newdexterity/Robotic-Speedboats/Trimaran/Version 2/Version 2 Stationary.jpg

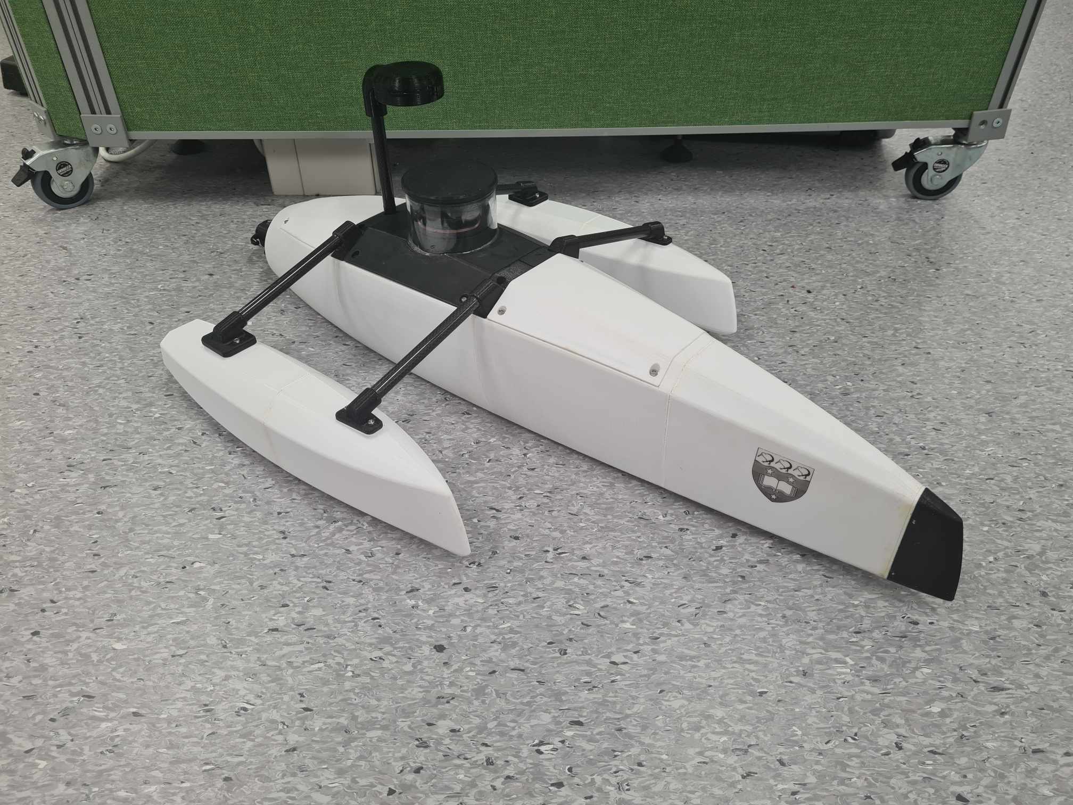
Trimaran/Version 2/Version 2 Stationary.jpg
