newdexterity/Robotic-Speedboats/Trimaran/Version 1 + 2.jpg

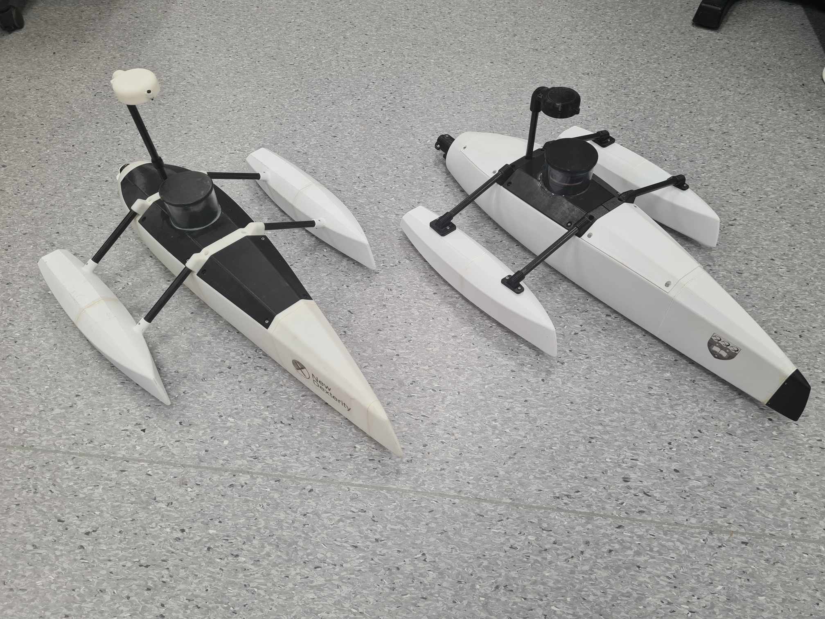
Trimaran/Version 1 + 2.jpg
