newdexterity/Robotic-Speedboats/Trimaran/Software/Software_Ardupilot_Trimaran.pdf

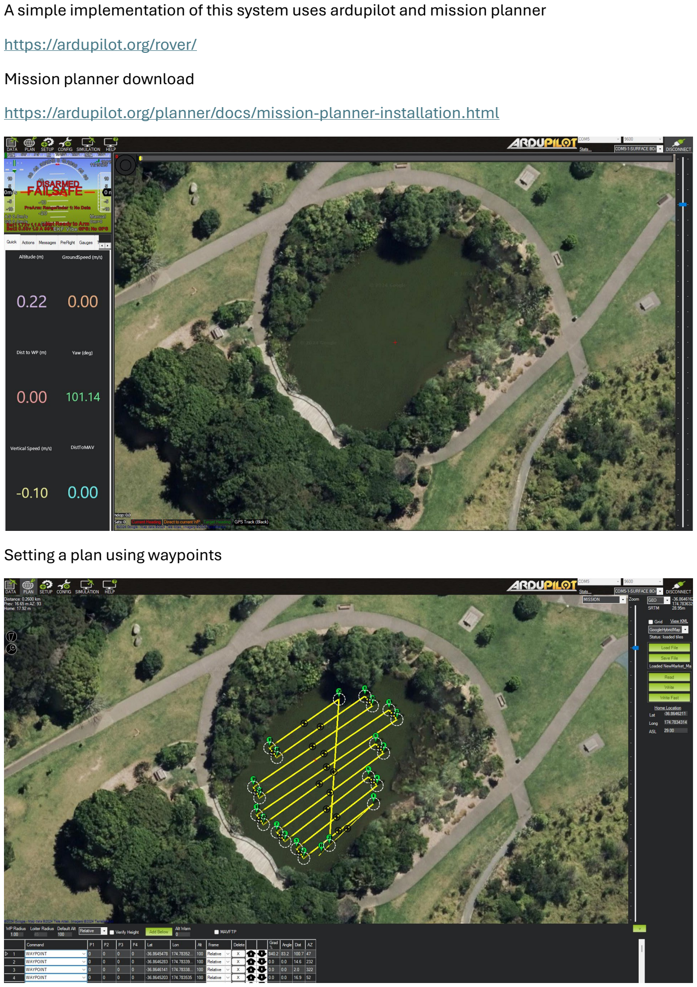
[picture p3: page 1]

A simple implementation of this system uses ardupilot and mission planner https://ardupilot.org/rover/
Mission planner download
https://ardupilot.org/planner/docs/mission-planner-installation.html

Setting a plan using waypoints

Tuning inputs

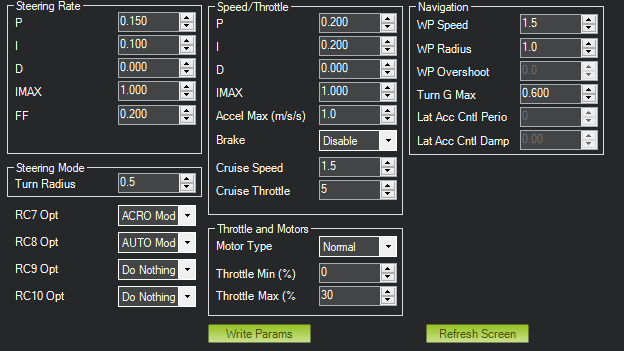
[picture p4: figure]

Parameters file can be used for the rest of the requirements
Overview of main parameters:
FRAME_CLASS = 2 (Boat)
Sonar (https://ardupilot.org/copter/docs/common-bluerobotics-ping.html)
- SERIAL2_PROTOCOL (https://ardupilot.org/copter/docs/parameters.html#serial2-protocol) = 9 (Lidar)
- SERIAL2_BAUD (https://ardupilot.org/copter/docs/parameters.html#serial2-baud) = 115 (115200 baud)
- RNGFND1_TYPE (https://ardupilot.org/copter/docs/parameters.html#rngfnd1-type) = 23 (BlueRoboticsPing)
- RNGFND1_MIN_CM (https://ardupilot.org/copter/docs/parameters.html#rngfnd1-min-cm) = 30
- RNGFND1_MAX_CM (https://ardupilot.org/copter/docs/parameters.html#rngfnd1-max-cm) = 2600. This is the distance in centimeters that the rangefinder can reliably read.
- RNGFND1_ORIENT (https://ardupilot.org/copter/docs/parameters.html#rngfnd1-orient) = 25 (down) if mounted on a boat

Lidar (https://ardupilot.org/copter/docs/common-rplidar-a2.html)
- SERIAL1_PROTOCOL (https://ardupilot.org/copter/docs/parameters.html#serial1-protocol) = “11” (“Lidar360”) if using Serial1
- SERIAL1_BAUD (https://ardupilot.org/copter/docs/parameters.html#serial1-baud) = “115” for C1/A2, “256” for S1,A2M12 if using Serial1
- PRX1_TYPE (https://ardupilot.org/copter/docs/parameters.html#prx1-type) = “5”
- PRX1_ORIENT (https://ardupilot.org/copter/docs/parameters.html#prx1-orient) = “0” if mounted on the top of the vehicle, “1” if mounted upside-down on the bottom of the vehicle.

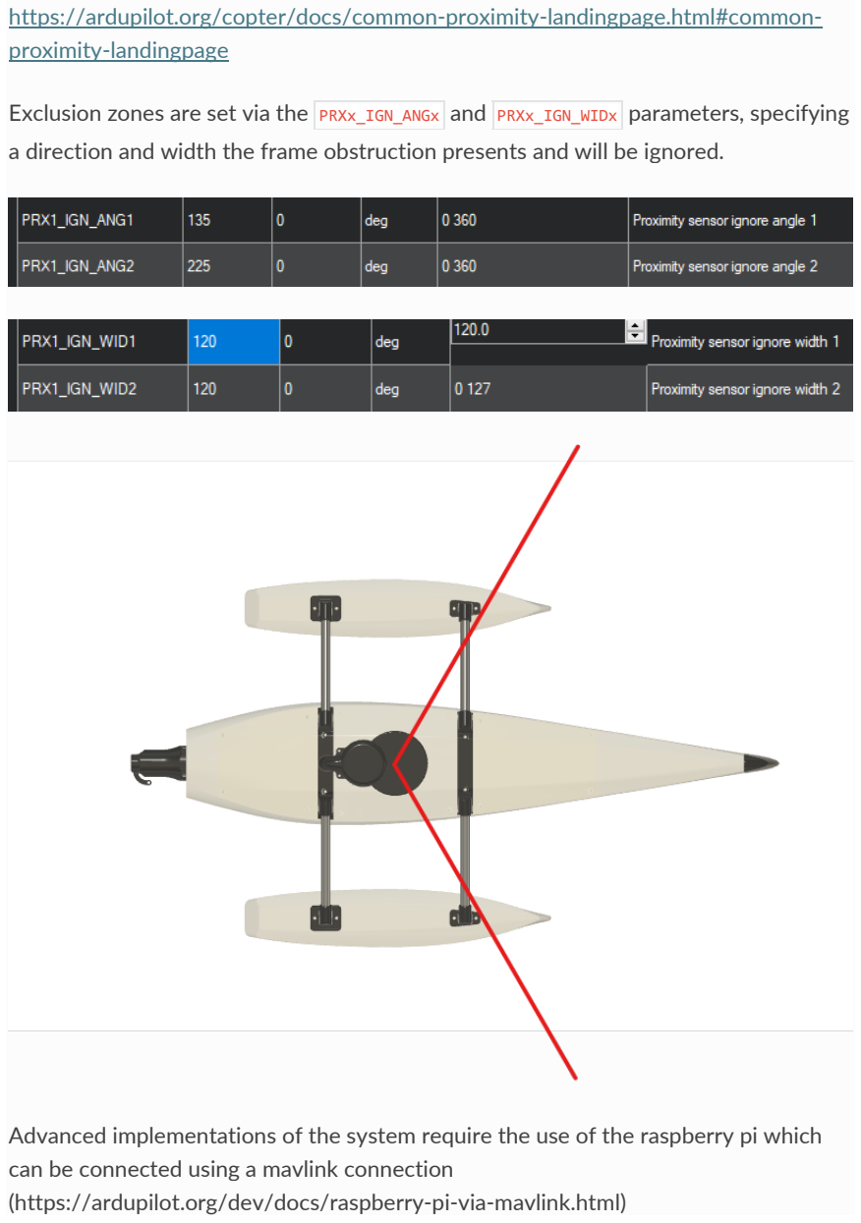
[picture p5: page 3]

https://ardupilot.org/copter/docs/common-proximity-landingpage.html#commonproximity-landingpage (https://ardupilot.org/copter/docs/common-proximity-landingpage.html#common-proximity-landingpage)

Exclusion zones are set via the | and | parameters, specifying
PRXx_IGN_ANGx | PRXx_IGN_WIDx
a direction and width the frame obstruction presents and will be ignored.

Advanced implementations of the system require the use of the raspberry pi which can be connected using a mavlink connection (https://ardupilot.org/dev/docs/raspberry-pi-via-mavlink.html)
