newdexterity/Robotic-Speedboats/Catamaran/Hull_Cover/Cover Rear.3mf

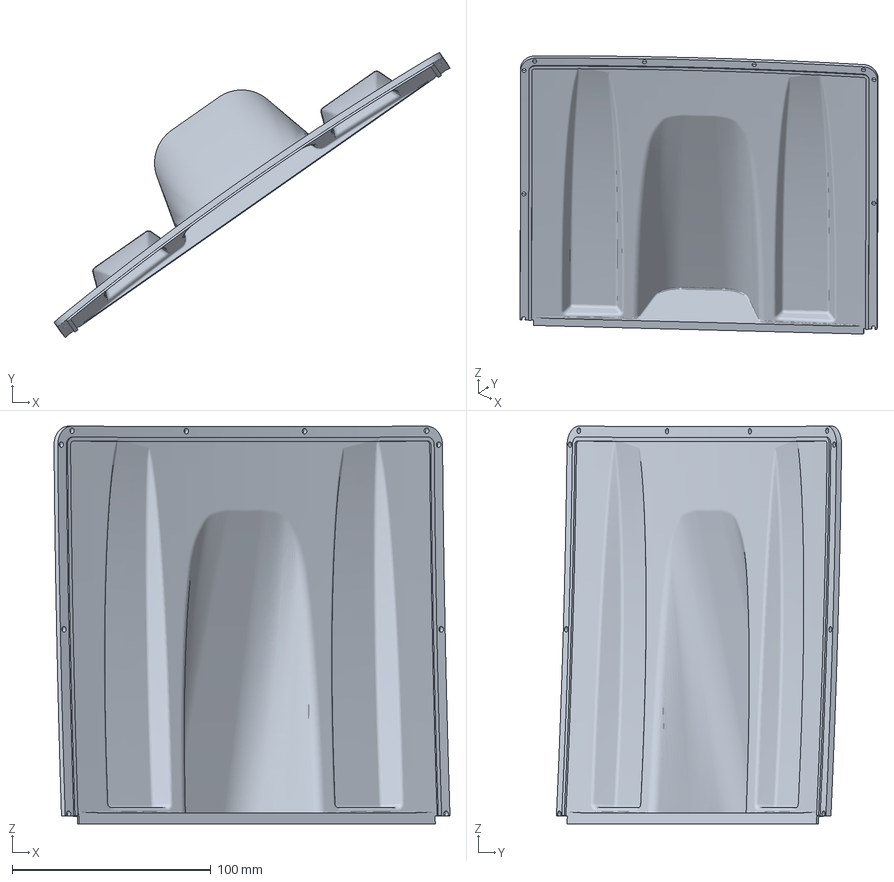
[picture p6: CAD file, 2021-09-22]
Catamaran/Hull_Cover/Cover Rear.3mf
199.0 x 143.3 x 199.9 mm
