newdexterity/Robotic-Speedboats/Catamaran/Hull_Cover/STEP/Hull_Cover.stp

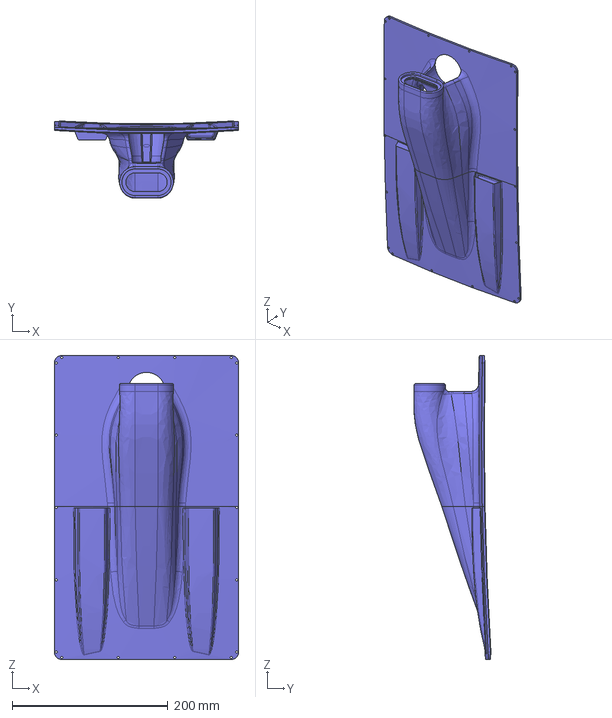
[picture p7: CAD file, 2024-03-28]
Catamaran/Hull_Cover/STEP/Hull_Cover.stp
236.5 x 98.8 x 390.0 mm
