newdexterity/Robotic-Speedboats/Catamaran/Jet/Impeller/Impeller_4-40-12.stp

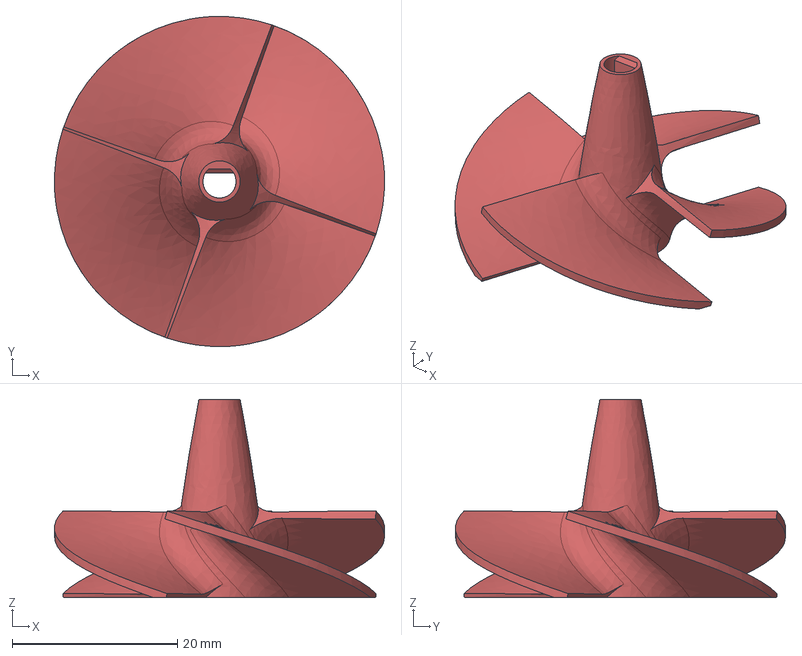
[picture p8: CAD file, 2024-03-28]
Catamaran/Jet/Impeller/Impeller_4-40-12.stp
40.0 x 40.0 x 24.0 mm
