newdexterity/Robotic-Speedboats/Catamaran/Jet/Thrust_vector.stp

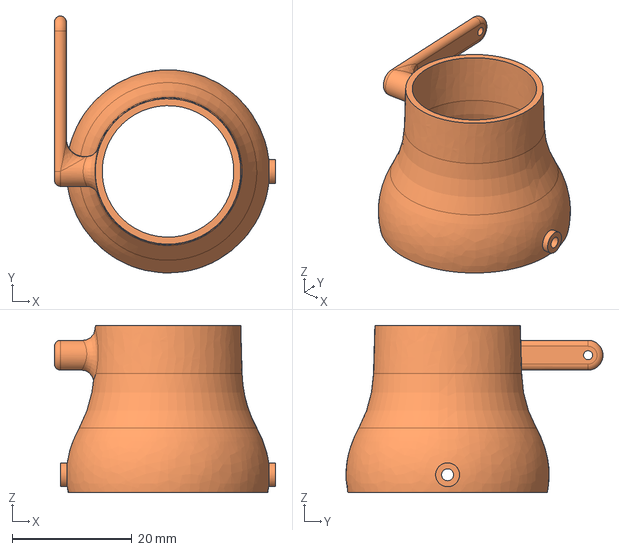
[picture p10: CAD file, 2024-03-28]
Catamaran/Jet/Thrust_vector.stp
37.0 x 43.0 x 28.0 mm
