newdexterity/Robotic-Speedboats/Catamaran/Mounts/Sensors_SubFrame.stp

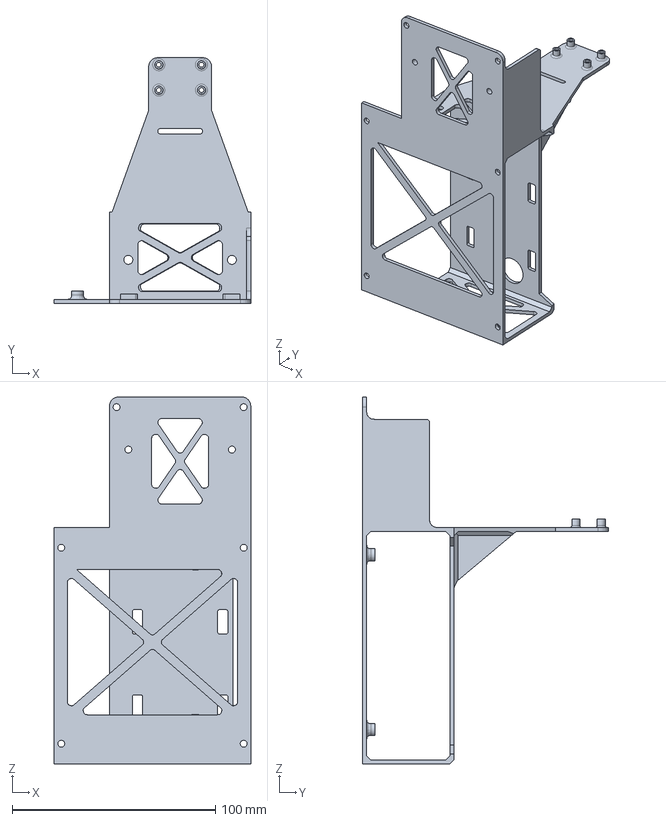
[picture p11: CAD file, 2024-03-28]
Catamaran/Mounts/Sensors_SubFrame.stp
96.8 x 121.0 x 180.7 mm
