newdexterity/Robotic-Speedboats/Trimaran/Version 2/Cover/Lid_Middle.3mf

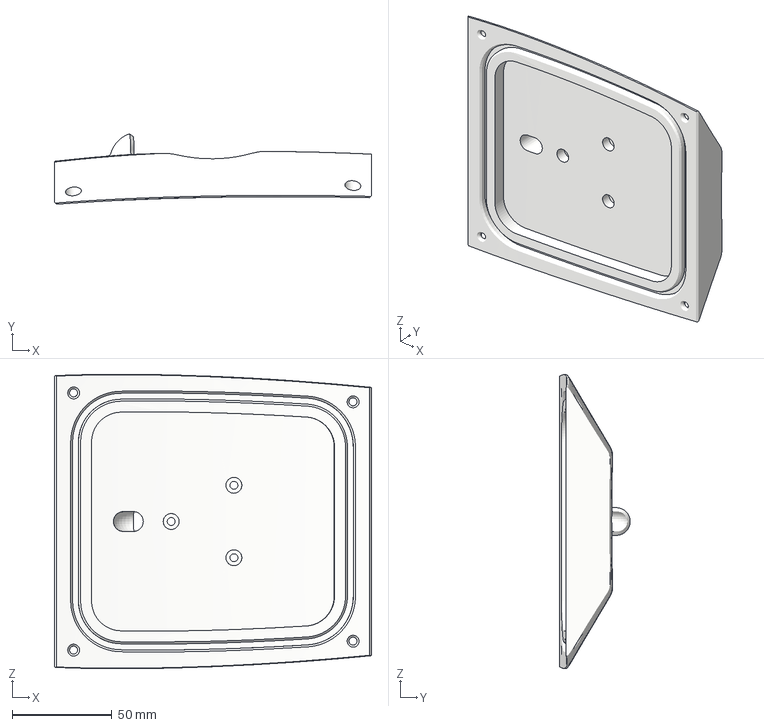
[picture p12: CAD file, 2024-07-31]
Trimaran/Version 2/Cover/Lid_Middle.3mf
159.2 x 35.4 x 147.9 mm
