newdexterity/Robotic-Speedboats/Trimaran/Version 2/Hull/Hull_tube_mount_right_rear.3mf

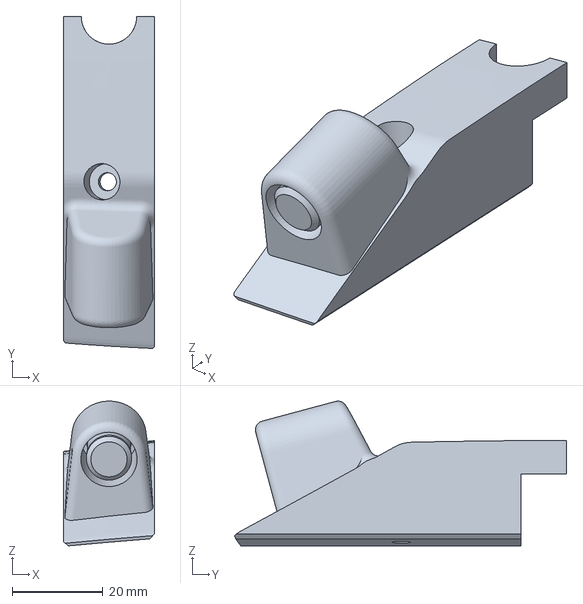
[picture p13: CAD file, 2024-07-31]
Trimaran/Version 2/Hull/Hull_tube_mount_right_rear.3mf
20.0 x 73.2 x 31.9 mm
