newdexterity/Robotic-Speedboats/Trimaran/Version 2/Jet/Stator.3mf

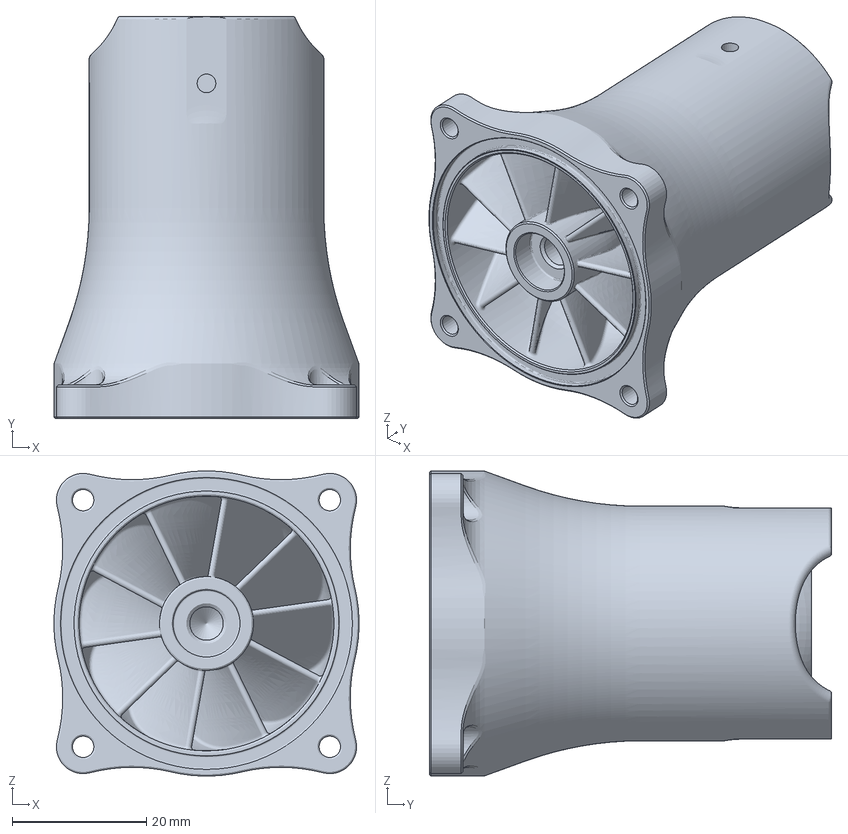
[picture p14: CAD file, 2024-03-28]
Trimaran/Version 2/Jet/Stator.3mf
45.5 x 60.0 x 45.5 mm
