newdexterity/Robotic-Speedboats/Trimaran/Version 2/Mount/RasberryPi_Box_Mount.3mf

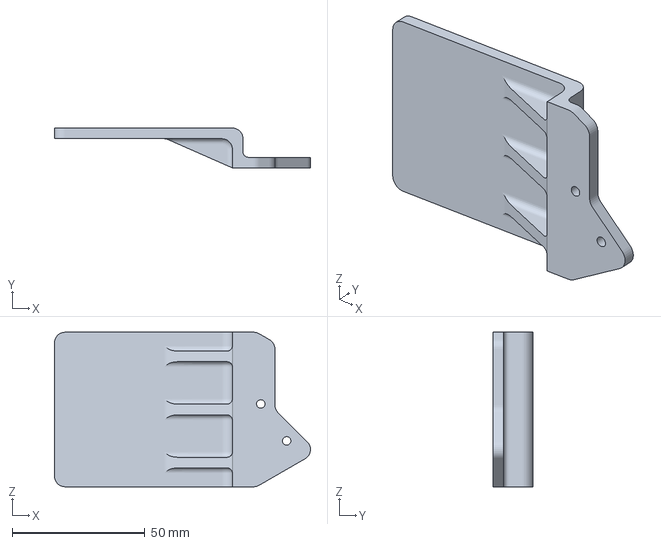
[picture p15: CAD file, 2024-03-28]
Trimaran/Version 2/Mount/RasberryPi_Box_Mount.3mf
96.4 x 15.0 x 58.2 mm
