newdexterity/Robotic-Speedboats/Catamaran/Hull_Cover/Hull Cutout Front.3mf

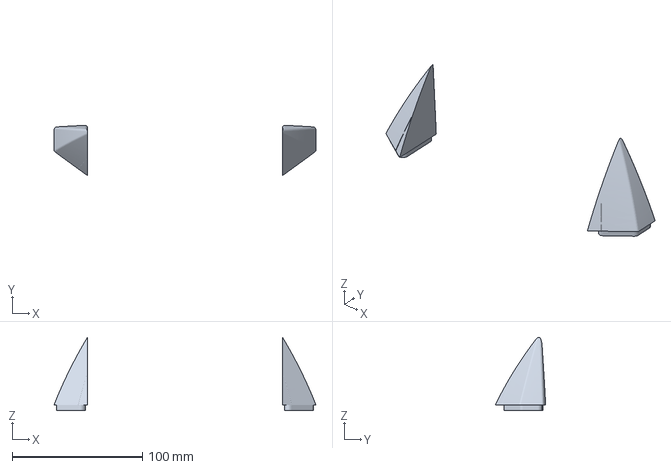
[picture p16: CAD file, 2021-09-22]
Catamaran/Hull_Cover/Hull Cutout Front.3mf
201.5 x 38.8 x 56.5 mm
