newdexterity/Robotic-Speedboats/Catamaran/Jet/Nozzle/Nozzle_25_12.stp

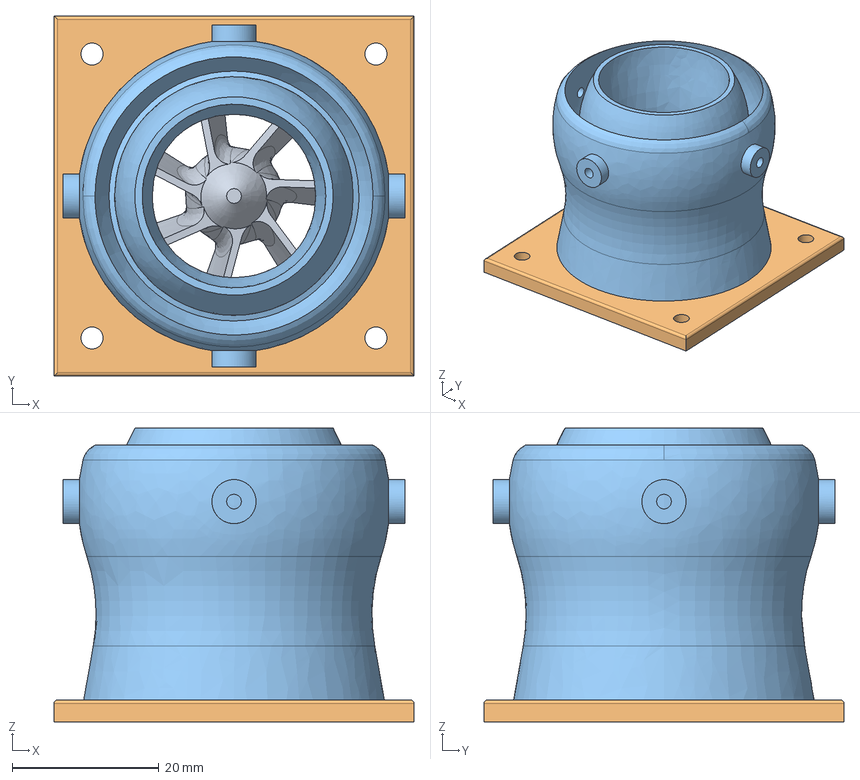
[picture p17: CAD file, 2024-03-28]
Catamaran/Jet/Nozzle/Nozzle_25_12.stp
49.0 x 49.0 x 40.0 mm
