newdexterity/Robotic-Speedboats/Catamaran/Jet/Reverse_Bucket.stp

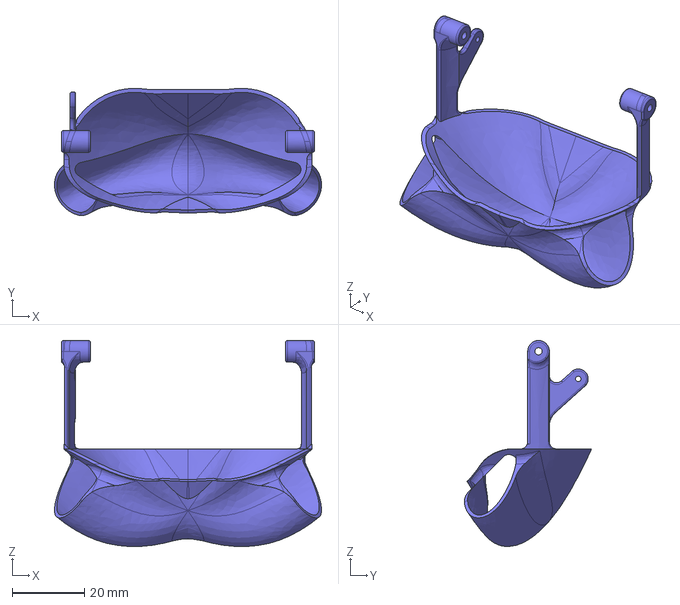
[picture p18: CAD file, 2024-03-28]
Catamaran/Jet/Reverse_Bucket.stp
73.9 x 35.2 x 57.0 mm
