newdexterity/Robotic-Speedboats/Catamaran/Mounts/Motor Mount.stp

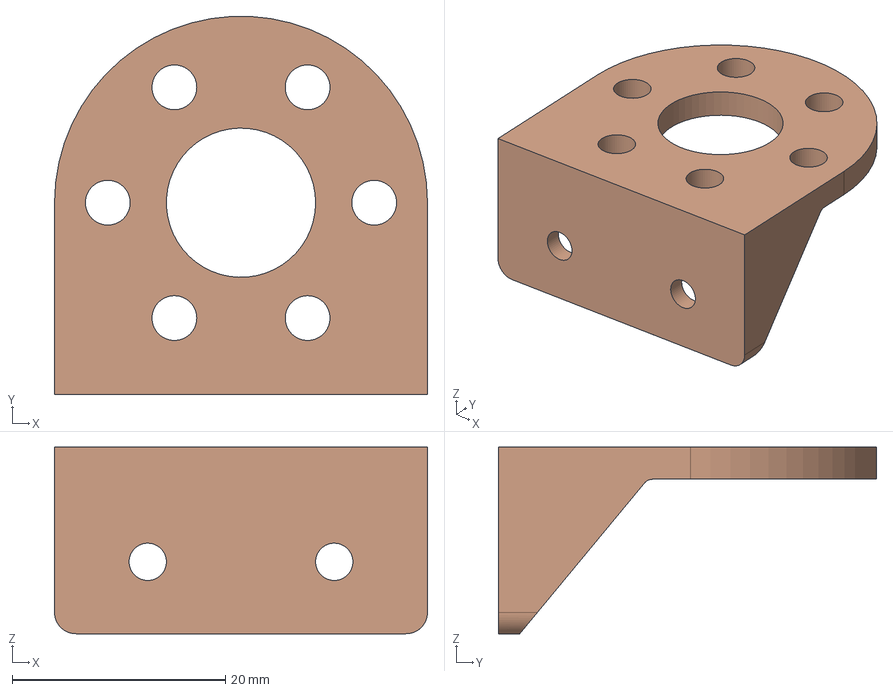
[picture p19: CAD file, 2024-03-28]
Catamaran/Mounts/Motor Mount.stp
35.0 x 35.5 x 17.5 mm
