newdexterity/Robotic-Speedboats/Trimaran/Version 2/Cover/Lid_Rear.3mf

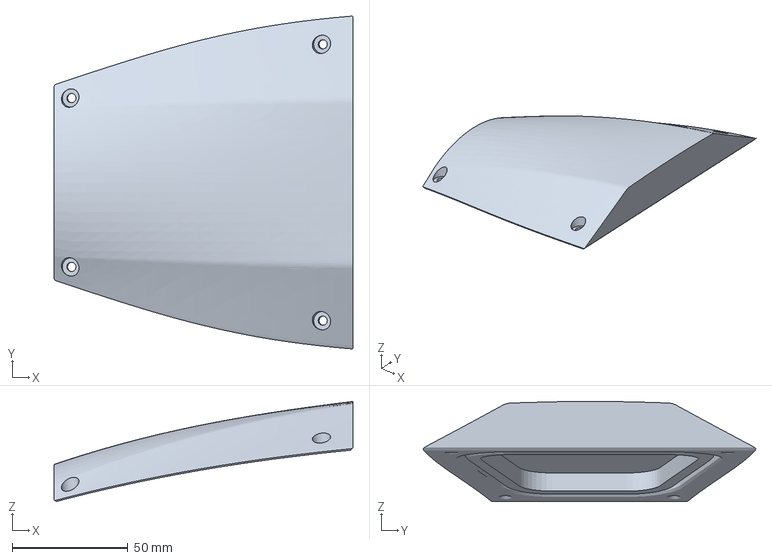
[picture p20: CAD file, 2024-03-28]
Trimaran/Version 2/Cover/Lid_Rear.3mf
129.2 x 143.8 x 43.3 mm
