newdexterity/Robotic-Speedboats/Trimaran/Version 2/Hull/Left_Rear_Side_Pod.3mf

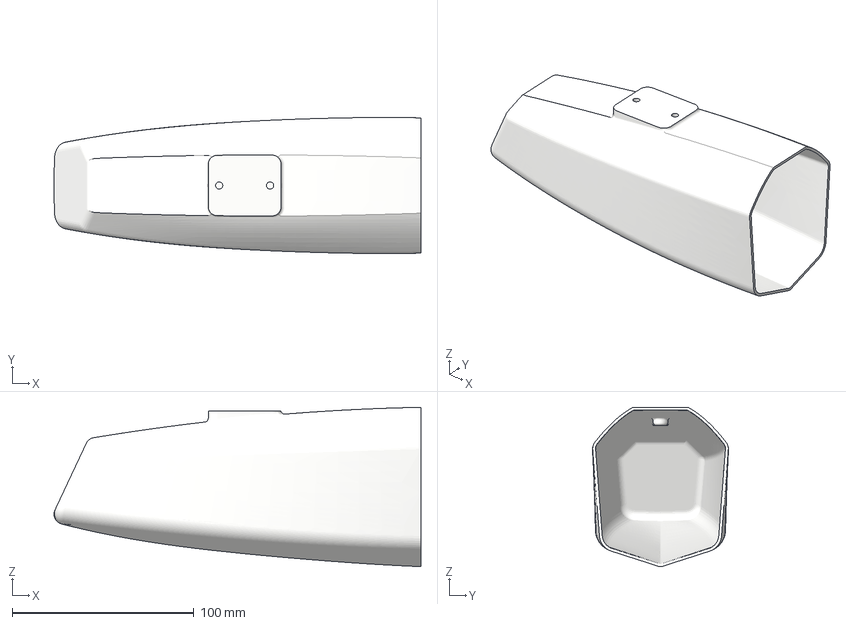
[picture p21: CAD file, 2024-07-31]
Trimaran/Version 2/Hull/Left_Rear_Side_Pod.3mf
201.8 x 74.8 x 87.6 mm
