newdexterity/Robotic-Speedboats/Trimaran/Version 2/Jet/Vector.3mf

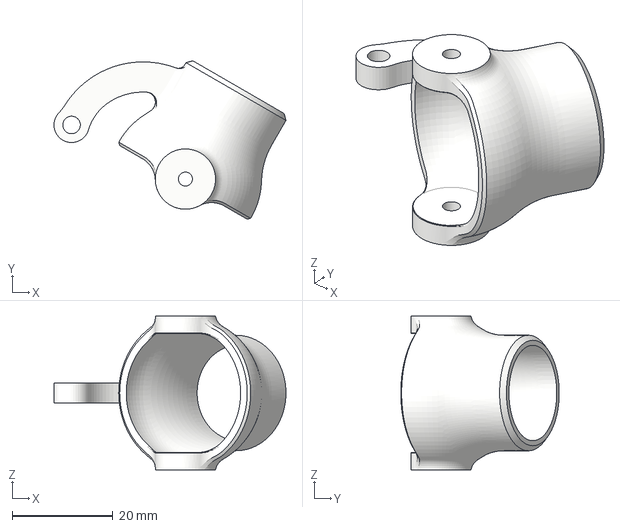
[picture p22: CAD file, 2024-03-28]
Trimaran/Version 2/Jet/Vector.3mf
46.2 x 31.5 x 30.6 mm
