newdexterity/Robotic-Speedboats/Trimaran/Version 2/Mount/Motor_Mount.3mf

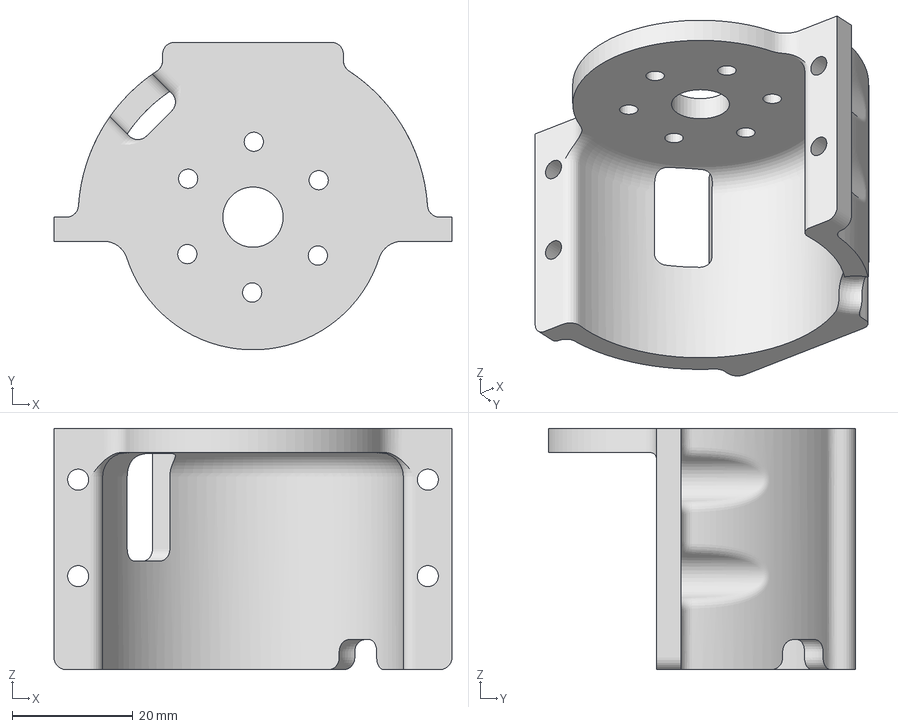
[picture p23: CAD file, 2024-03-28]
Trimaran/Version 2/Mount/Motor_Mount.3mf
66.0 x 51.0 x 40.0 mm
