newdexterity/Robotic-Speedboats/Catamaran/Hull_Cover/Hull Cutout Mid Rear.3mf

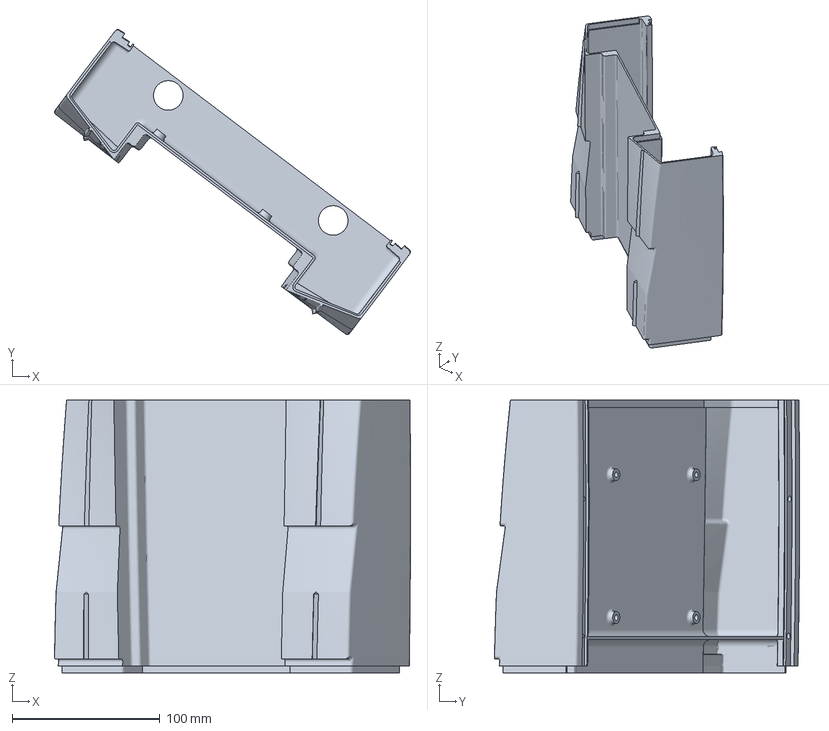
[picture p24: CAD file, 2021-09-22]
Catamaran/Hull_Cover/Hull Cutout Mid Rear.3mf
240.8 x 206.4 x 184.5 mm
