newdexterity/Robotic-Speedboats/Catamaran/Jet/Thrust_vector-Nozzle_20.stl

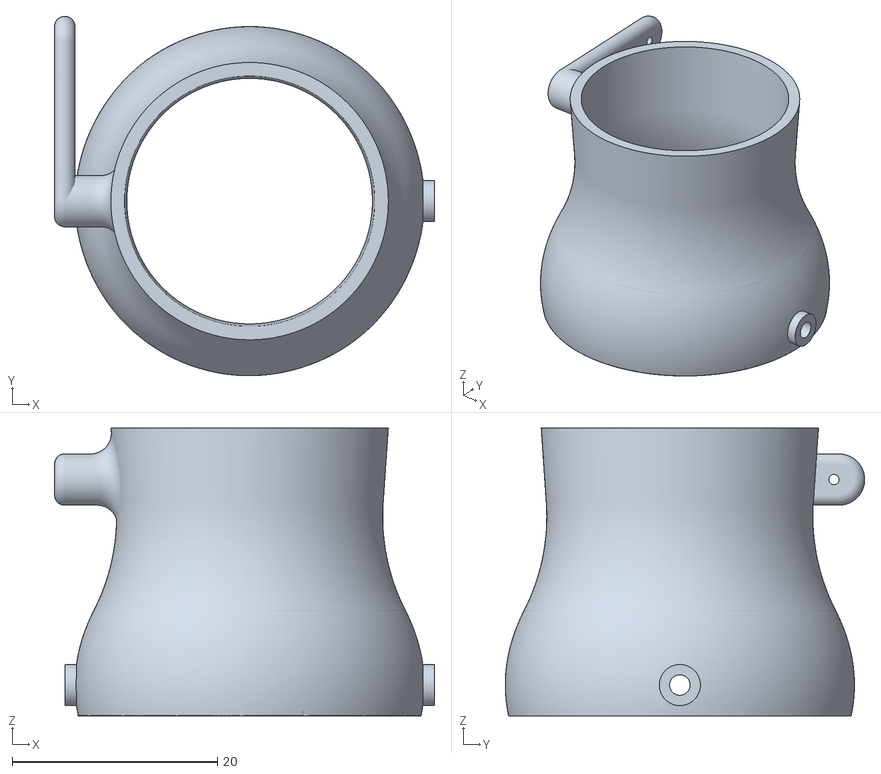
[picture p25: CAD file, 2021-09-22]
Catamaran/Jet/Thrust_vector-Nozzle_20.stl
37.0 x 35.0 x 28.0
