newdexterity/Robotic-Speedboats/Catamaran/Mounts/Powertrain_SubFrame.stp

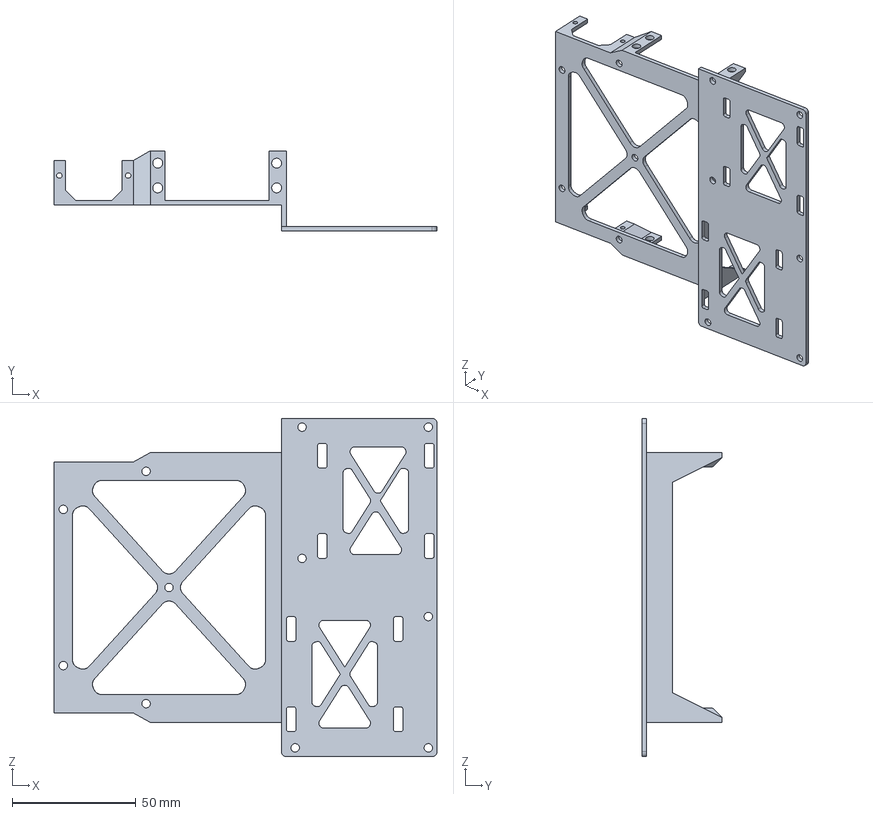
[picture p26: CAD file, 2024-03-28]
Catamaran/Mounts/Powertrain_SubFrame.stp
154.7 x 32.5 x 136.5 mm
