newdexterity/Robotic-Speedboats/Trimaran/Version 2/Cover/Lid_Front.3mf

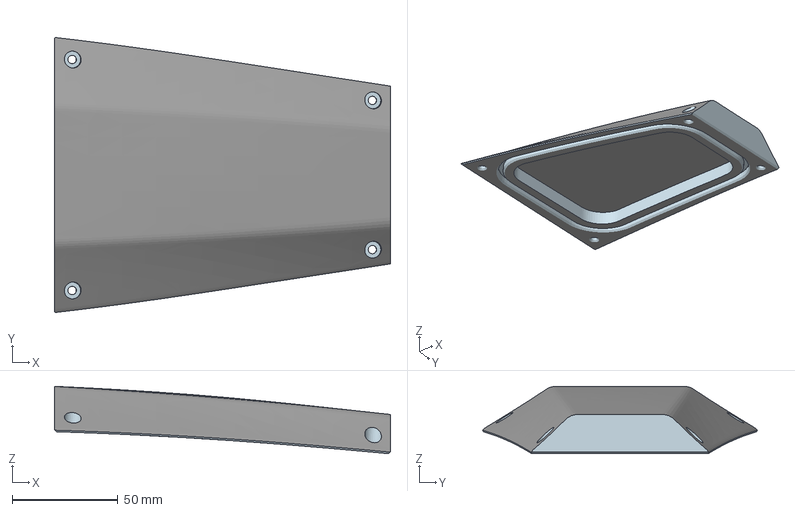
[picture p27: CAD file, 2024-03-28]
Trimaran/Version 2/Cover/Lid_Front.3mf
159.2 x 130.3 x 31.9 mm
