newdexterity/Robotic-Speedboats/Trimaran/Version 2/Hull/Side_pod_tube_mount_left_rear.3mf

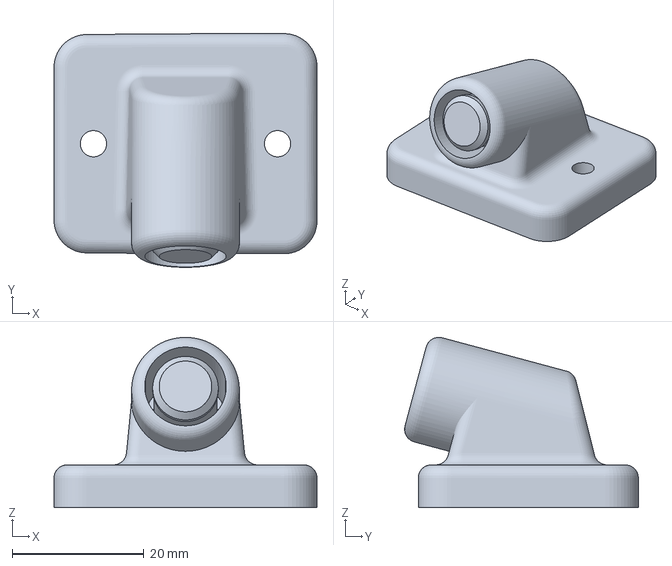
[picture p28: CAD file, 2024-07-31]
Trimaran/Version 2/Hull/Side_pod_tube_mount_left_rear.3mf
40.0 x 35.6 x 25.9 mm
