newdexterity/Robotic-Speedboats/Trimaran/Version 2/Mount/Pixhawk_Box_Holder.3mf

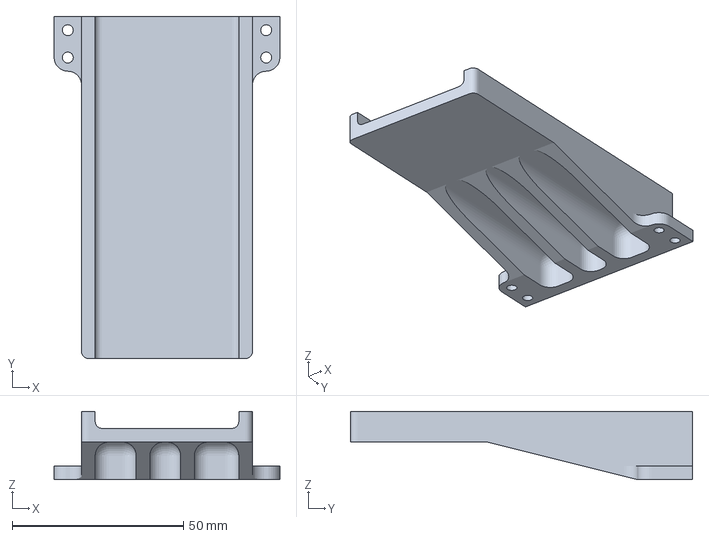
[picture p29: CAD file, 2024-03-28]
Trimaran/Version 2/Mount/Pixhawk_Box_Holder.3mf
66.0 x 100.0 x 20.0 mm
