newdexterity/Robotic-Speedboats/Catamaran/Hull_Cover/Hull Cutout Rear.3mf

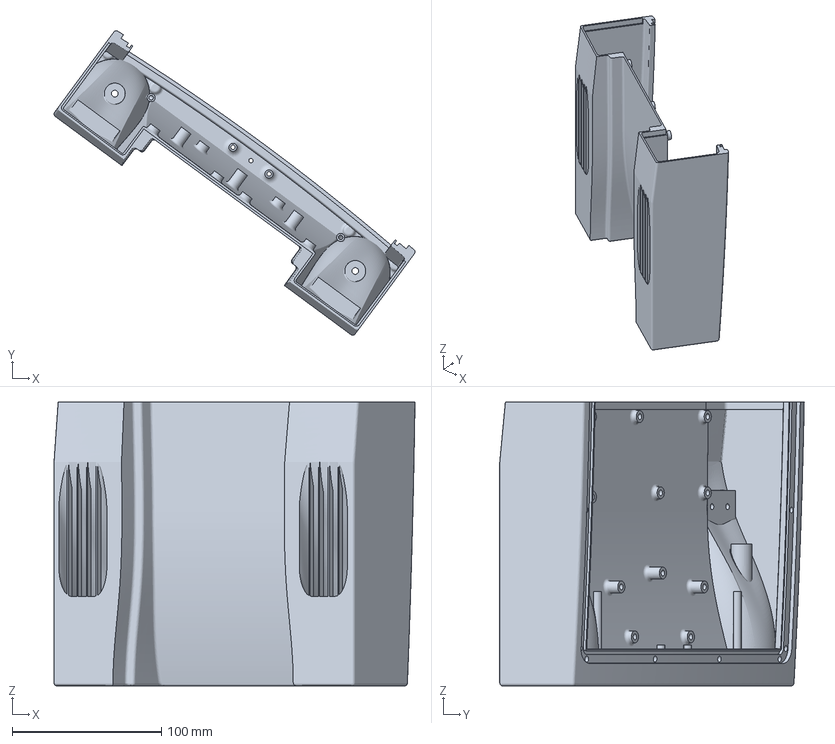
[picture p30: CAD file, 2021-09-22]
Catamaran/Hull_Cover/Hull Cutout Rear.3mf
241.6 x 203.8 x 190.0 mm
