newdexterity/Robotic-Speedboats/Catamaran/Jet/Impeller/Impeller_20_40_4.stl

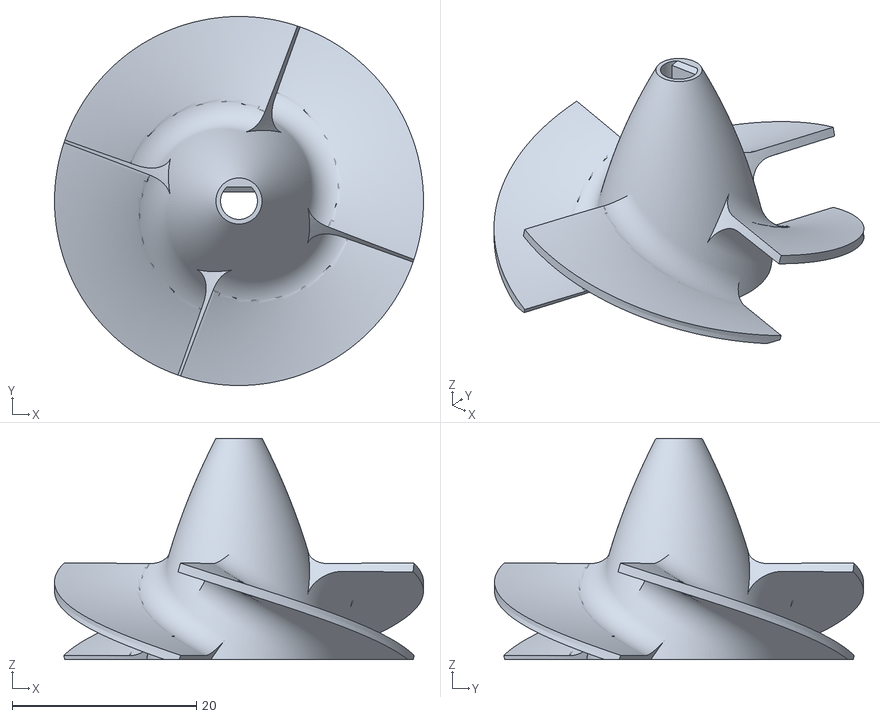
[picture p31: CAD file, 2021-09-22]
Catamaran/Jet/Impeller/Impeller_20_40_4.stl
40.0 x 40.0 x 24.0
