newdexterity/Robotic-Speedboats/Trimaran/Version 2/Hull/Hull_tube_mount_left_front.3mf

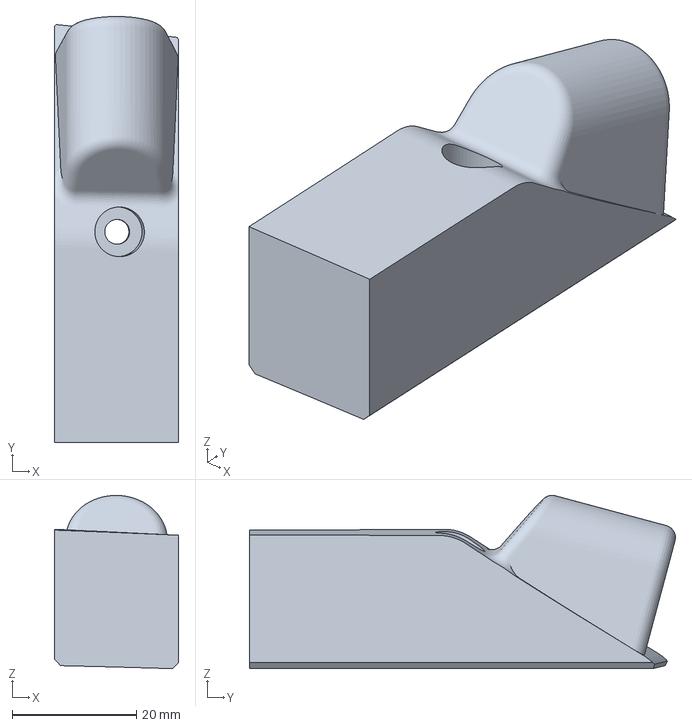
[picture p32: CAD file, 2024-07-31]
Trimaran/Version 2/Hull/Hull_tube_mount_left_front.3mf
20.0 x 68.6 x 27.9 mm
