newdexterity/Robotic-Speedboats/Trimaran/Version 2/Mount/Servo_Mount.3mf

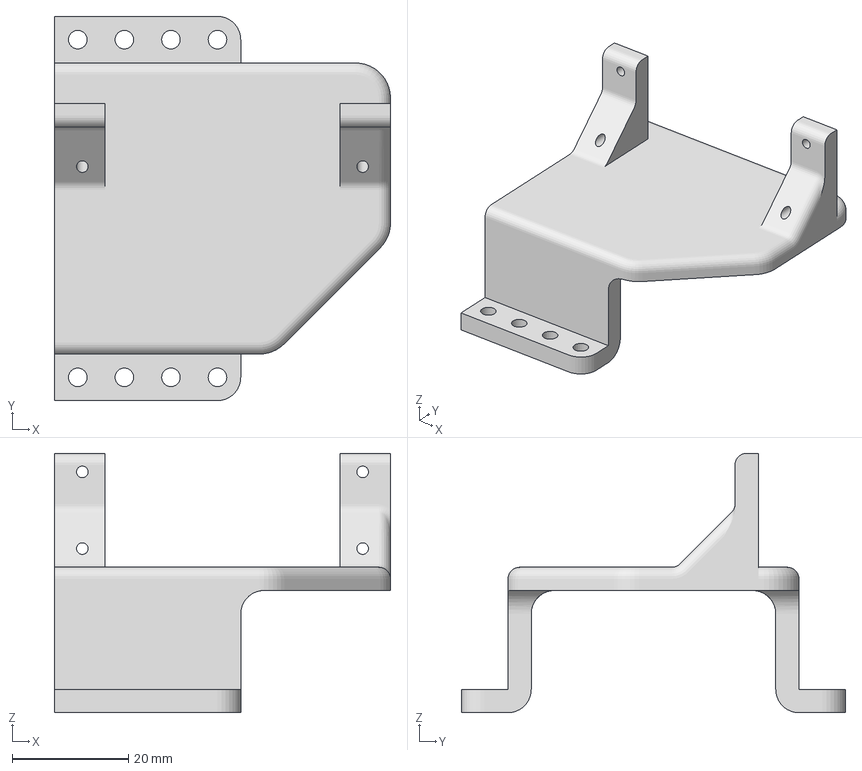
[picture p33: CAD file, 2024-03-28]
Trimaran/Version 2/Mount/Servo_Mount.3mf
57.7 x 66.0 x 44.6 mm
