newdexterity/Robotic-Speedboats/Catamaran/Hull_Cover/Cover Front.3mf

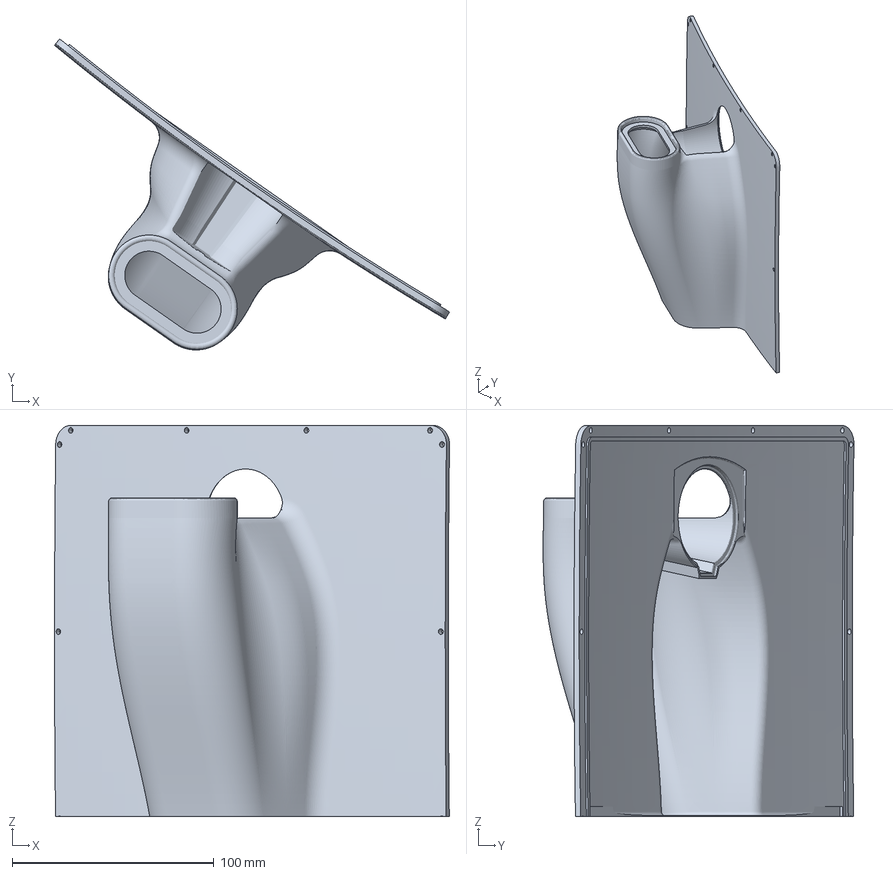
[picture p34: CAD file, 2021-09-22]
Catamaran/Hull_Cover/Cover Front.3mf
195.8 x 154.2 x 194.0 mm
