newdexterity/Robotic-Speedboats/Catamaran/Jet/Impeller/Impeller_12_50_4.stl

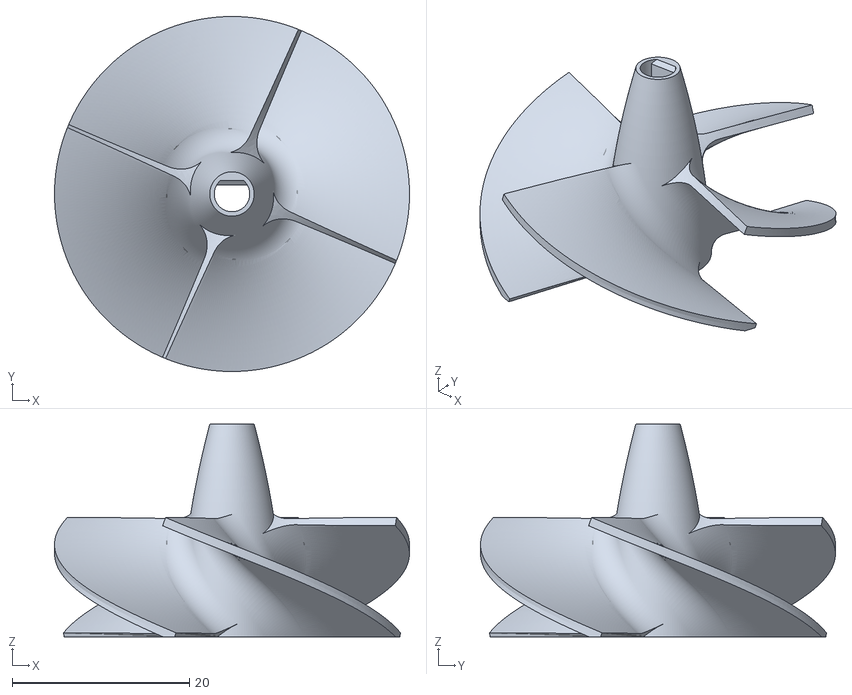
[picture p35: CAD file, 2021-09-22]
Catamaran/Jet/Impeller/Impeller_12_50_4.stl
40.0 x 40.0 x 24.0
