newdexterity/Robotic-Speedboats/Trimaran/Version 2/Hull/Left_Front_Side_Pod.3mf

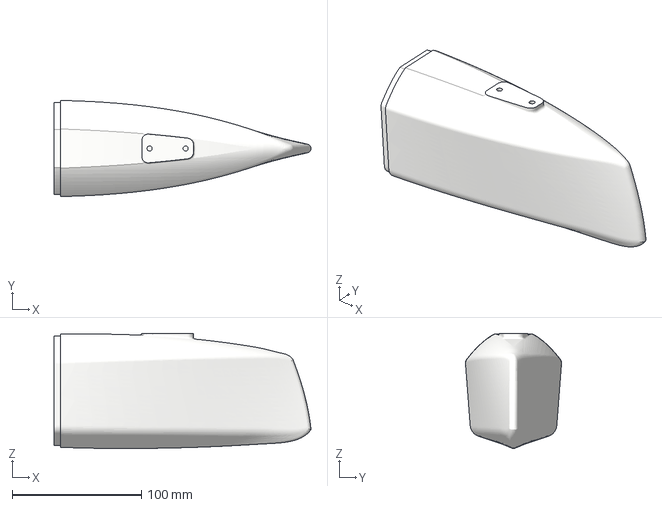
[picture p36: CAD file, 2024-07-31]
Trimaran/Version 2/Hull/Left_Front_Side_Pod.3mf
199.1 x 74.4 x 89.1 mm
