newdexterity/Robotic-Speedboats/Trimaran/Version 2/Mount/Sonar_Top.3mf

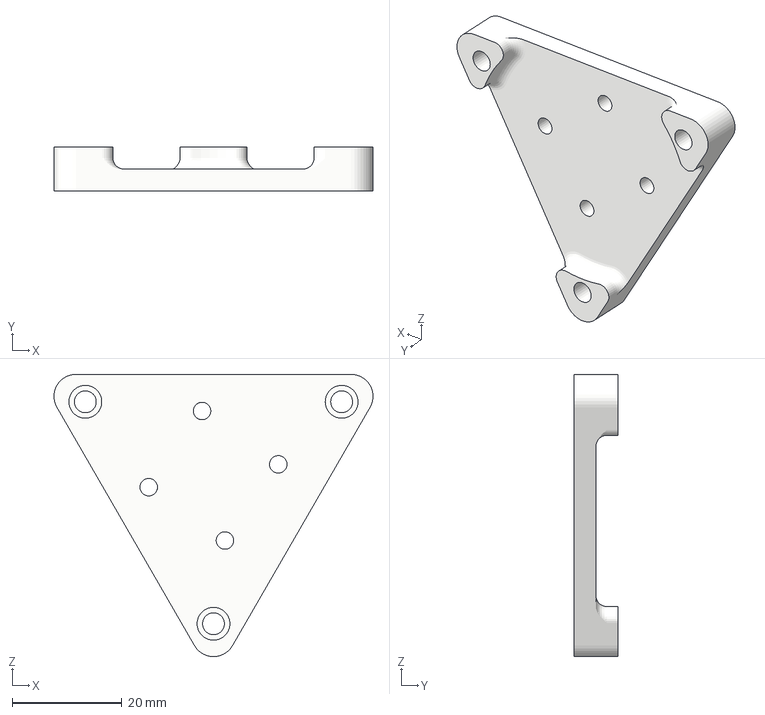
[picture p37: CAD file, 2024-03-28]
Trimaran/Version 2/Mount/Sonar_Top.3mf
58.2 x 8.00 x 51.5 mm
