newdexterity/Robotic-Speedboats/Catamaran/Hull_Cover/Hull Cutout Front Mid.3mf

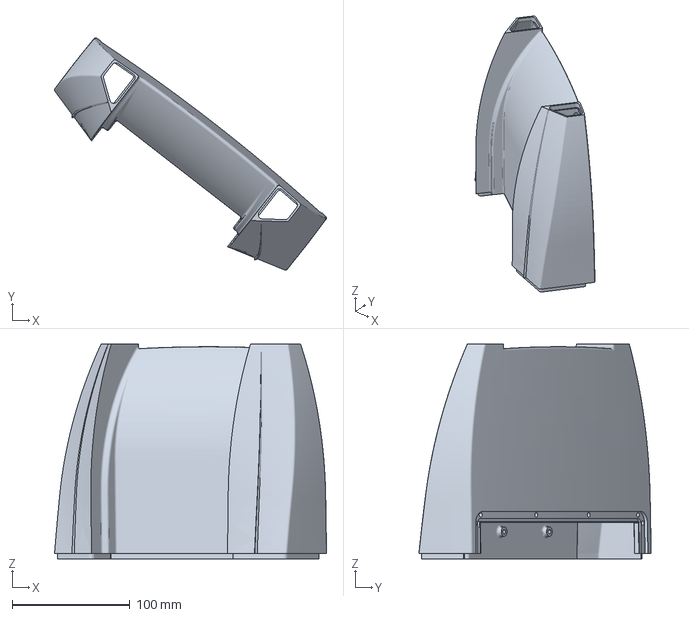
[picture p38: CAD file, 2021-09-22]
Catamaran/Hull_Cover/Hull Cutout Front Mid.3mf
231.0 x 197.2 x 182.5 mm
