newdexterity/Robotic-Speedboats/Trimaran/Version 2/Mount/GPS_TOP.3mf

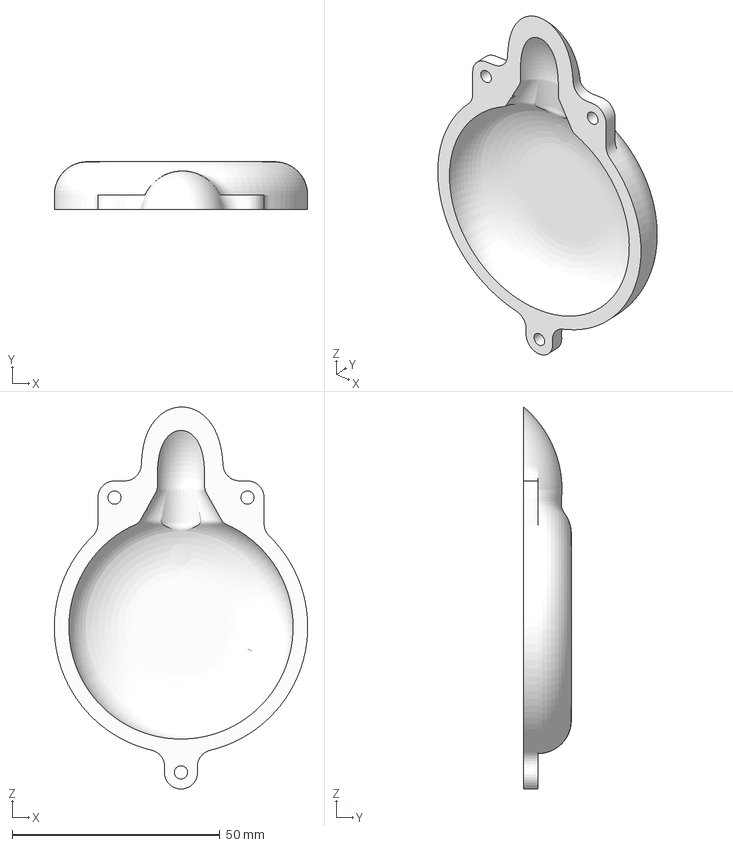
[picture p39: CAD file, 2024-03-28]
Trimaran/Version 2/Mount/GPS_TOP.3mf
61.0 x 11.5 x 91.9 mm
