newdexterity/Robotic-Speedboats/Trimaran/Version 2/Mount/GPS_BASE.3mf

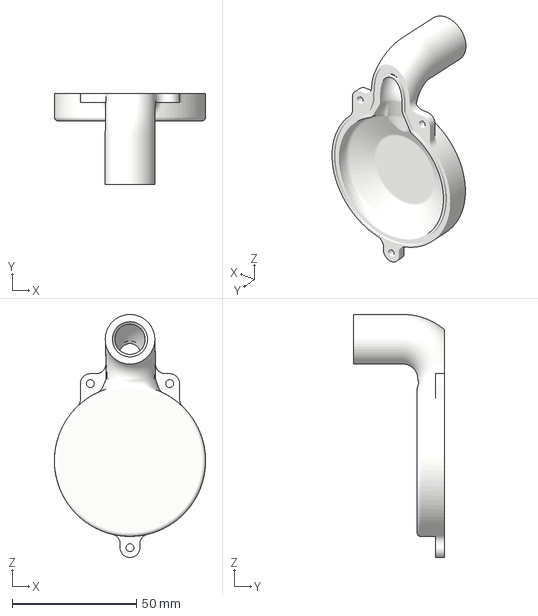
[picture p40: CAD file, 2024-03-28]
Trimaran/Version 2/Mount/GPS_BASE.3mf
61.0 x 36.6 x 98.0 mm
