newdexterity/Robotic-Speedboats/Trimaran/Version 2/Hull/Side_Pod_Tube_Mount_front_Left.3mf

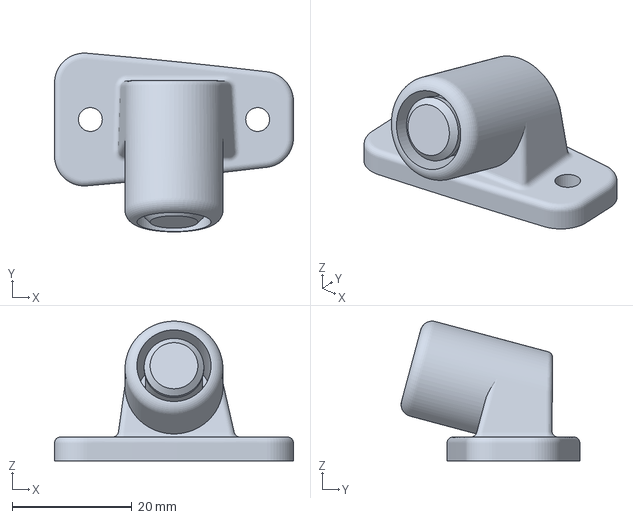
[picture p41: CAD file, 2024-07-31]
Trimaran/Version 2/Hull/Side_Pod_Tube_Mount_front_Left.3mf
40.0 x 29.9 x 23.4 mm
