newdexterity/Robotic-Speedboats/Trimaran/Version 2/Hull/Nose_Tip.3mf

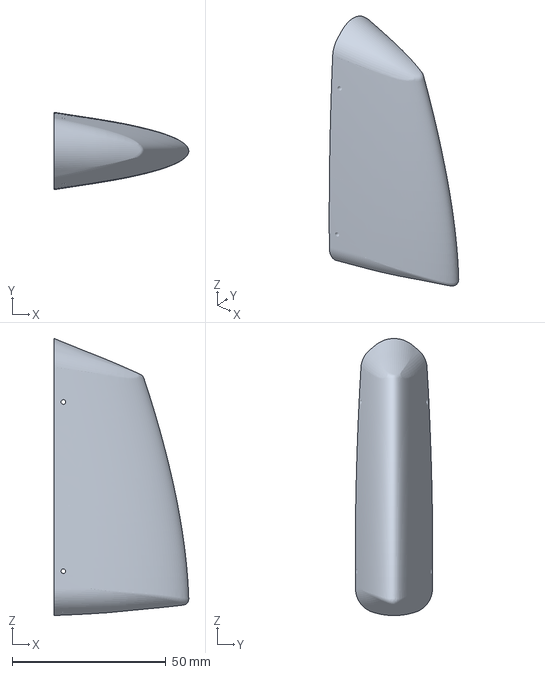
[picture p42: CAD file, 2024-07-31]
Trimaran/Version 2/Hull/Nose_Tip.3mf
43.8 x 25.1 x 90.0 mm
