newdexterity/Robotic-Speedboats/Trimaran/Version 2/Hull/Hull_Nose.3mf

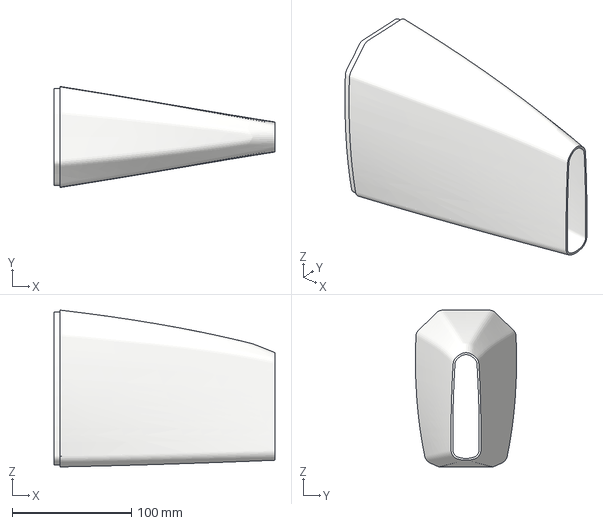
[picture p43: CAD file, 2024-07-31]
Trimaran/Version 2/Hull/Hull_Nose.3mf
185.0 x 84.6 x 131.3 mm
