newdexterity/Robotic-Speedboats/Trimaran/Version 2/Hull/Hull_Rear.3mf

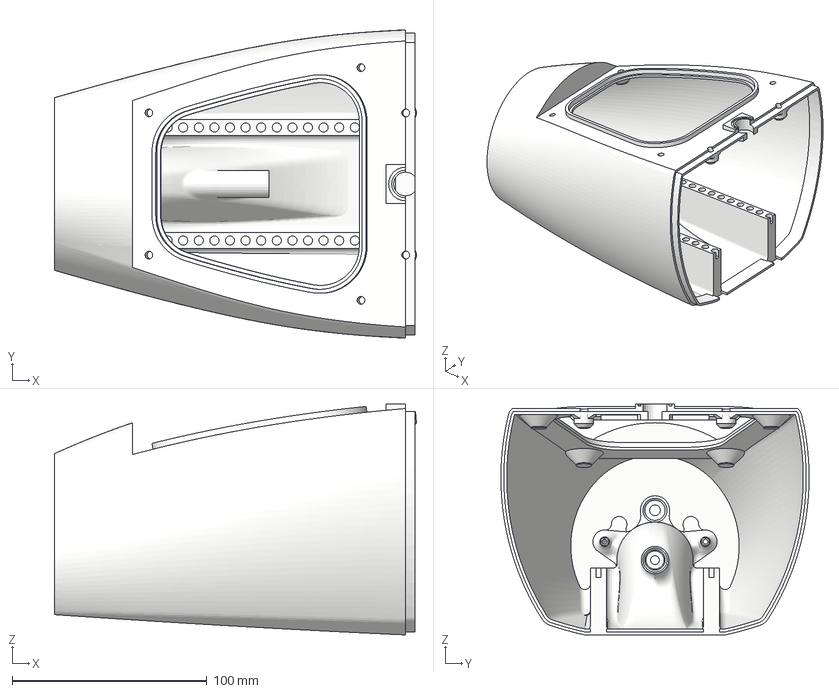
[picture p44: CAD file, 2024-07-31]
Trimaran/Version 2/Hull/Hull_Rear.3mf
185.6 x 158.1 x 118.4 mm
