newdexterity/Robotic-Speedboats/Trimaran/Version 2/Hull/Hull_Middle.3mf

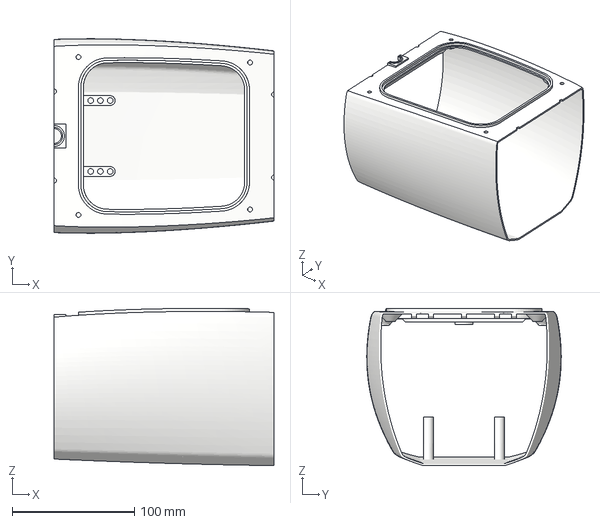
[picture p45: CAD file, 2024-07-31]
Trimaran/Version 2/Hull/Hull_Middle.3mf
180.0 x 159.2 x 128.7 mm
