newdexterity/Robotic-Speedboats/Trimaran/Version 2/Hull/Hull_Front.3mf

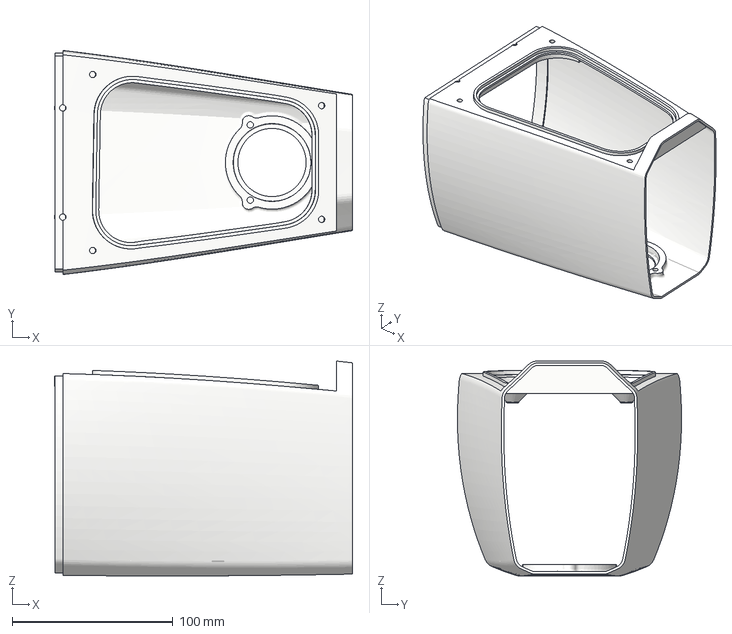
[picture p46: CAD file, 2024-07-31]
Trimaran/Version 2/Hull/Hull_Front.3mf
185.2 x 139.3 x 133.6 mm
