newdexterity/Robotic-Speedboats/(list of files, cad)

Other CAD files:
Catamaran/Jet/Impeller/Impeller_12_40_5.stl
Catamaran/Jet/Impeller/Impeller_12_40_4.stl
Catamaran/Jet/Impeller/Impeller_12_30_4.stl
Trimaran/Version 2/Hull/Hull_tube_mount_right_front.3mf
Catamaran/Jet/Impeller/Impeller_12_40_3.stl
Trimaran/Version 2/Hull/Side_pod_tube_mount_right_rear.3mf
Trimaran/Version 2/Hull/Right_front_side_pod.3mf
Trimaran/Version 2/Hull/Hull_tube_mount_left_rear.3mf
Trimaran/Version 2/Hull/Side_pod_tube_mount_right_front.3mf
Trimaran/Version 2/Hull/Right_rear_side_pod.3mf
Catamaran/Jet/Reverse_Bucket.stl
Catamaran/Mounts/Motor Mount.stl
Catamaran/Mounts/Powertrain_SubFrame.stl
Catamaran/Mounts/Sensors_SubFrame.stl
Trimaran/Version 1/Cover/Hull_Cover_2.3mf
Trimaran/Version 1/Hull/Hull_1.3mf
Trimaran/Version 1/Hull/Hull_2.3mf
Trimaran/Version 1/Hull/Hull_3.3mf
Trimaran/Version 1/Hull/Hull_4.3mf
Trimaran/Version 1/Hull/Hull_5.3mf
Trimaran/Version 1/Hull/Hull_Left_2.3mf
Trimaran/Version 1/Hull/Hull_Mount_Front_Left.3mf
Trimaran/Version 1/Hull/Hull_Mount_Front_Right.3mf
Trimaran/Version 1/Hull/Hull_Mount_Rear_Left.3mf
Trimaran/Version 1/Hull/Hull_Mount_Rear_Right.3mf
Trimaran/Version 1/Hull/Hull_Right_1.3mf
Trimaran/Version 1/Hull/Hull_Right_2.3mf
Trimaran/Version 1/Hull/Hull_left_1.3mf
