newdexterity/Robotic-Speedboats/Trimaran/Build_Instructions_Trimaran_V2.pdf

# Trimaran Assembly Guide

## Autonomous Driving Boat

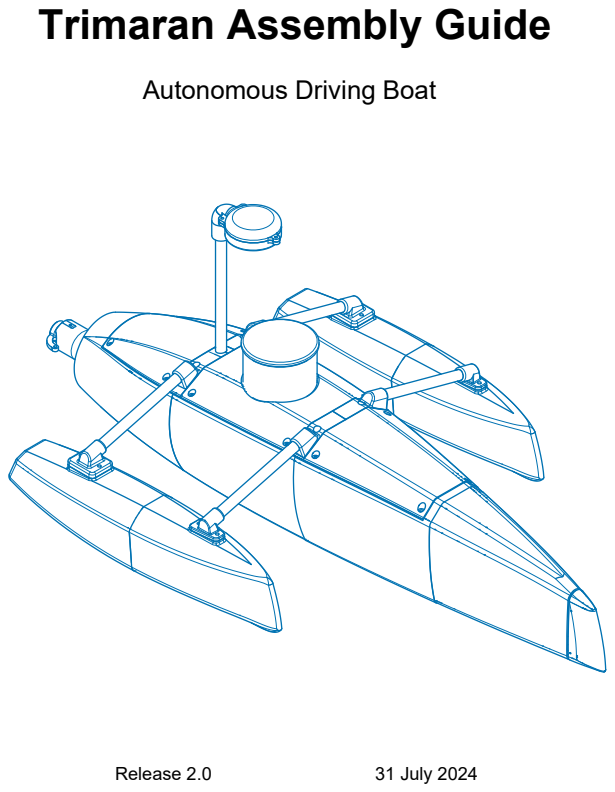
[picture p47: page 1]
Release 2.0; 31 July 2024

# Bill of Materials

## DIAGRAM Part

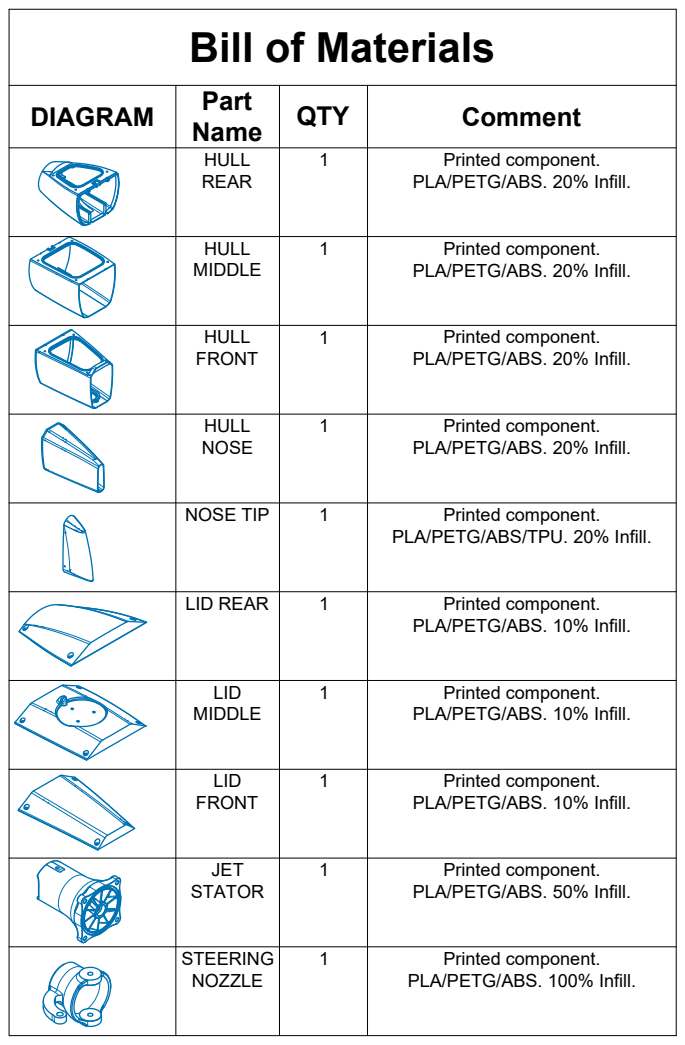
[picture p48: page 2]
Name; QTY; Comment; HULL REAR; Printed component.; HULL MIDDLE; HULL FRONT; HULL NOSE; NOSE TIP; LID REAR; LID MIDDLE; LID FRONT; JET STATOR; STEERING NOZZLE

PLA/PETG/ABS. 20% Infill.

PLA/PETG/ABS/TPU. 20% Infill.

PLA/PETG/ABS. 10% Infill.

PLA/PETG/ABS. 50% Infill.

PLA/PETG/ABS. 100% Infill.

# Bill of Materials

## DIAGRAM Part

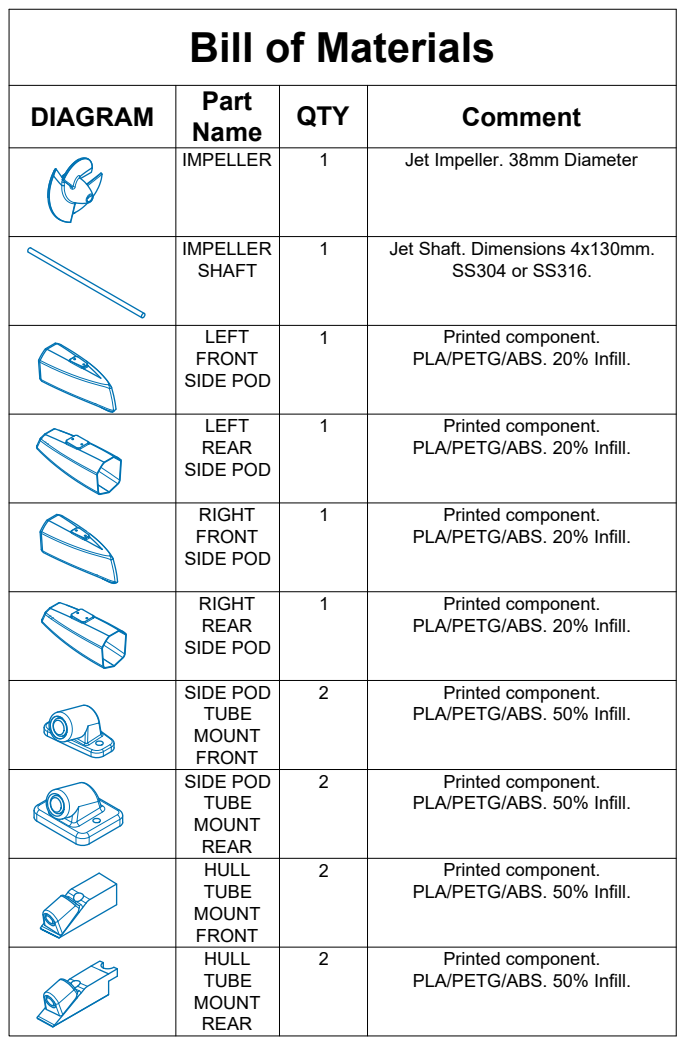
[picture p49: page 3]
Name; QTY; Comment; IMPELLER; Jet Impeller. 38mm Diameter; IMPELLER SHAFT; Jet Shaft. Dimensions 4x130mm.; LEFT FRONT SIDE POD; Printed component.; LEFT REAR SIDE POD; RIGHT FRONT SIDE POD; RIGHT REAR SIDE POD; SIDE POD TUBE MOUNT FRONT; SIDE POD TUBE MOUNT REAR; HULL TUBE MOUNT FRONT; HULL TUBE MOUNT REAR

PLA/PETG/ABS. 20% Infill.

PLA/PETG/ABS. 50% Infill.

# Bill of Materials

## DIAGRAM Part

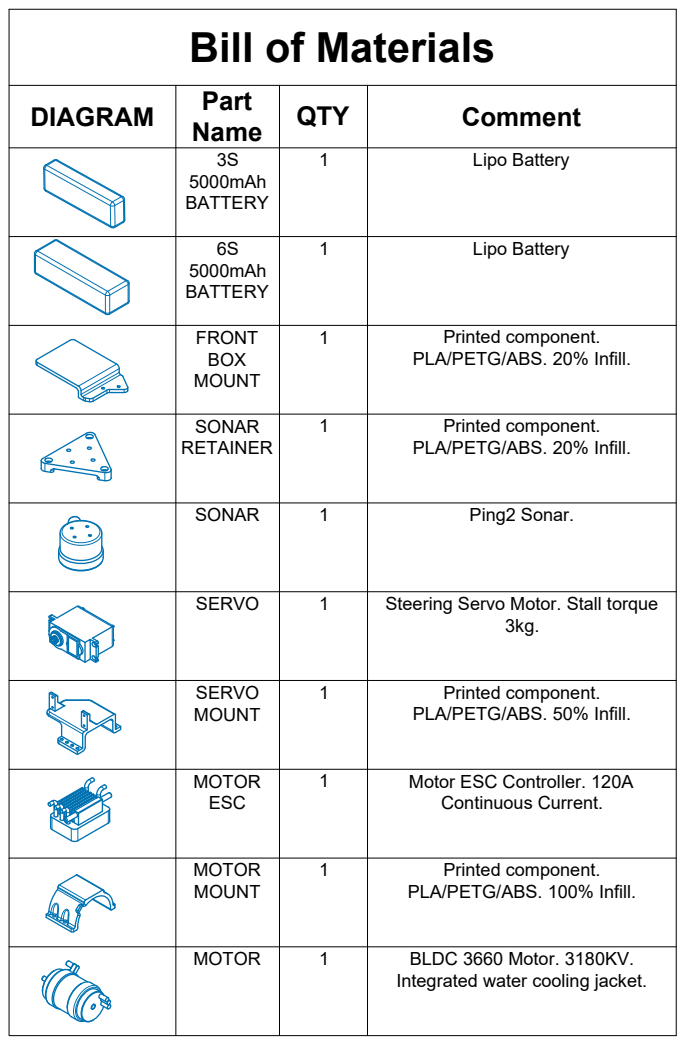
[picture p50: page 4]
Name; QTY; Comment; 3S 5000mAh BATTERY; Lipo Battery; 6S 5000mAh BATTERY; FRONT BOX MOUNT; Printed component.; SONAR RETAINER; SONAR; Ping2 Sonar.; SERVO; Steering Servo Motor. Stall torque; SERVO MOUNT; MOTOR ESC; Motor ESC Controller. 120A; Continuous Current.; MOTOR MOUNT; MOTOR; BLDC 3660 Motor. 3180KV.

PLA/PETG/ABS. 20% Infill.

PLA/PETG/ABS. 50% Infill.

PLA/PETG/ABS. 100% Infill.

Integrated water cooling jacket.

# Bill of Materials

## DIAGRAM Part

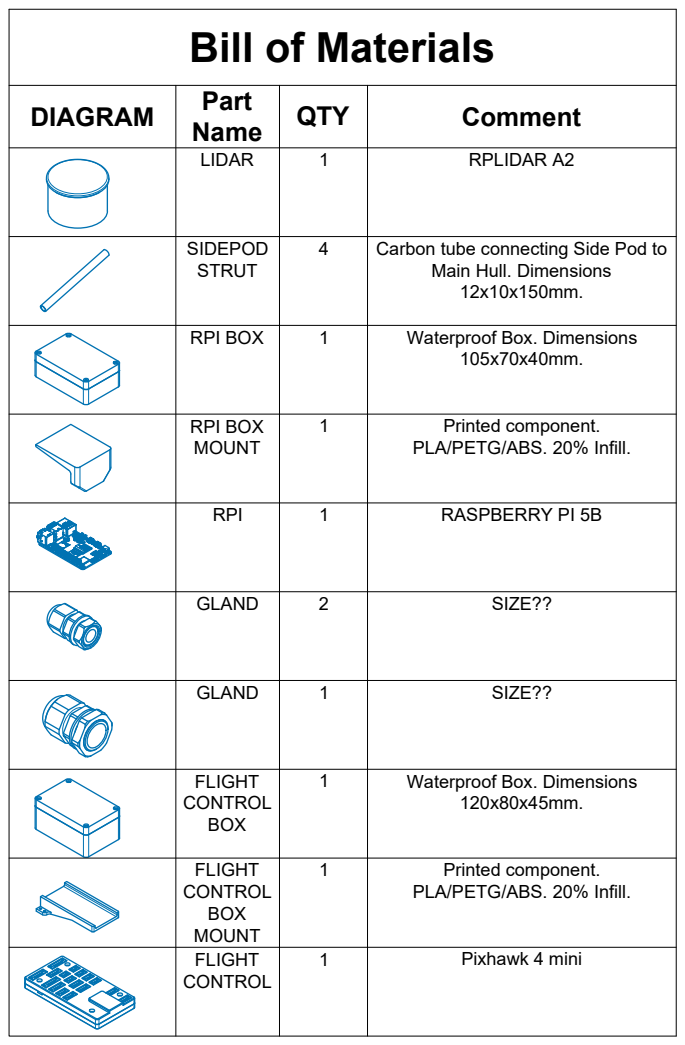
[picture p51: page 5]
Name; QTY; Comment; LIDAR; RPLIDAR A2; SIDEPOD STRUT; Carbon tube connecting Side Pod to; RPI BOX; Waterproof Box. Dimensions; RPI BOX MOUNT; Printed component.; RPI; RASPBERRY PI 5B; GLAND; SIZE??; FLIGHT CONTROL BOX; FLIGHT CONTROL BOX MOUNT; FLIGHT CONTROL; Pixhawk 4 mini

Main Hull. Dimensions

PLA/PETG/ABS. 20% Infill.

# Bill of Materials

## DIAGRAM Part

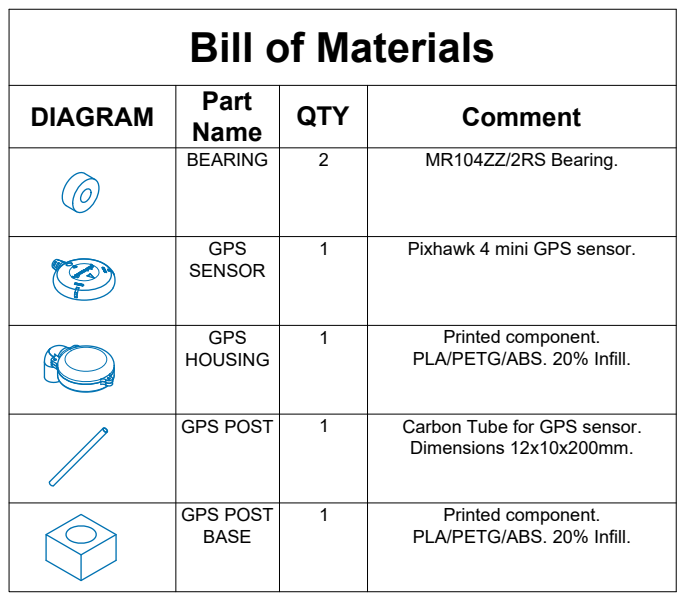
[picture p52: page 6]
Name; QTY; Comment; BEARING; MR104ZZ/2RS Bearing.; GPS SENSOR; Pixhawk 4 mini GPS sensor.; GPS HOUSING; Printed component.; GPS POST; Carbon Tube for GPS sensor.; Dimensions 12x10x200mm.; GPS POST BASE

PLA/PETG/ABS. 20% Infill.

## HULL FRONT ASSEMBLY

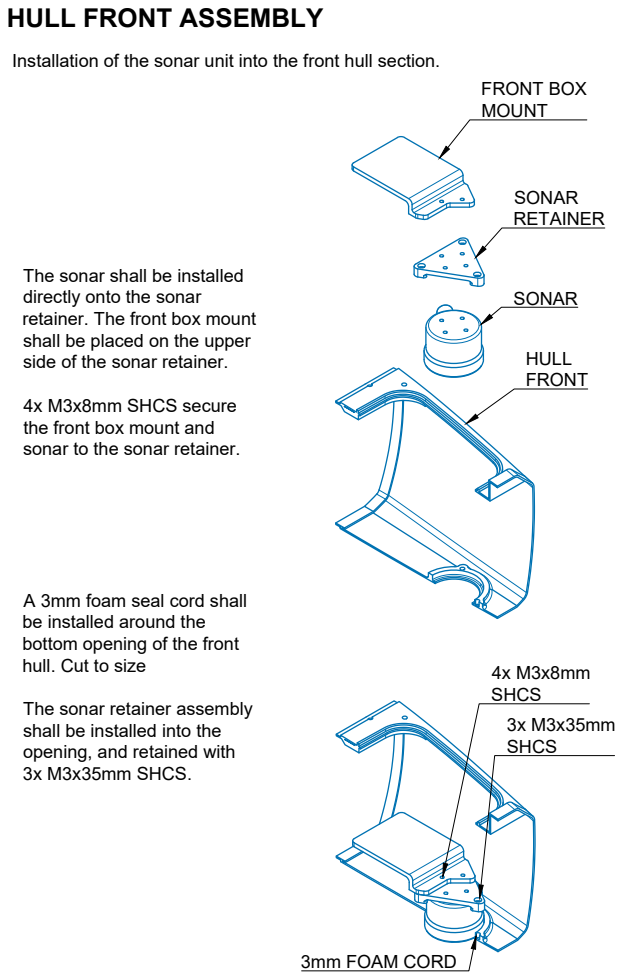
[picture p53: page 7]
FRONT BOX MOUNT; SONAR RETAINER; SONAR; HULL FRONT; 3mm FOAM CORD; 3x M3x35mm SHCS; 4x M3x8mm SHCS

Installation of the sonar unit into the front hull section.

The sonar shall be installed
directly onto the sonar
retainer. The front box mount
shall be placed on the upper
side of the sonar retainer.

4x M3x8mm SHCS secure
the front box mount and
sonar to the sonar retainer.

A 3mm foam seal cord shall
be installed around the
bottom opening of the front
hull. Cut to size

The sonar retainer assembly
shall be installed into the
opening, and retained with
3x M3x35mm SHCS.

## CENTRE HULL ASSEMBLY

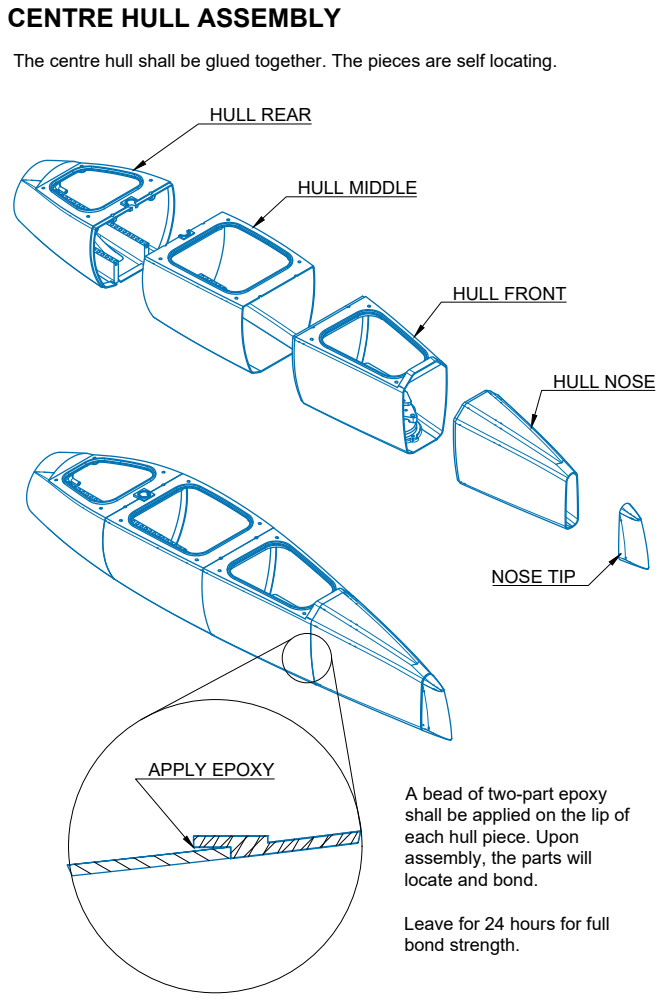
[picture p54: page 8]
HULL MIDDLE; HULL REAR; HULL FRONT; HULL NOSE; APPLY EPOXY; NOSE TIP

The centre hull shall be glued together. The pieces are self locating.

A bead of two-part epoxy
shall be applied on the lip of
each hull piece. Upon
assembly, the parts will
locate and bond.

Leave for 24 hours for full
bond strength.

## OUTBOARD JET ASSEMBLY

Installation of the jet stator, impeller and steering mechanism.

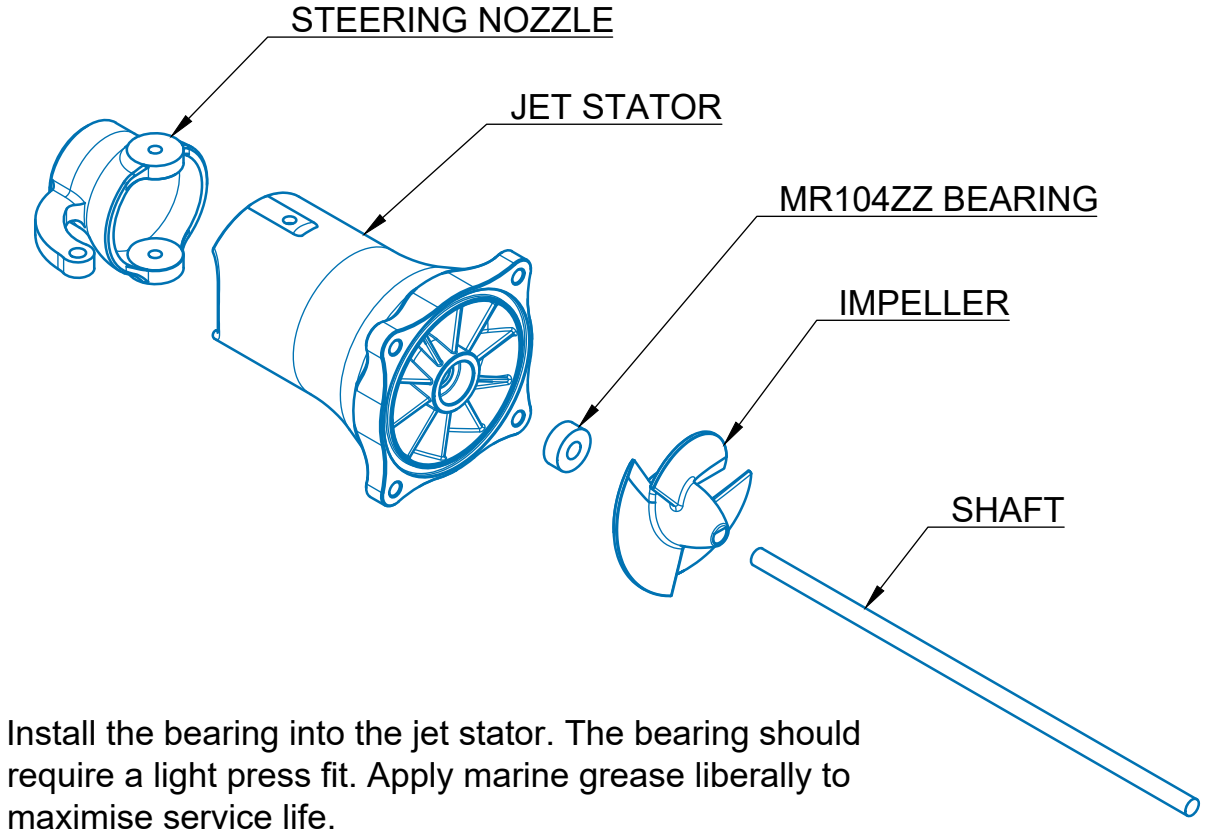
[picture p55: figure]
maximise service life.; IMPELLER; SHAFT; MR104ZZ BEARING; JET STATOR; STEERING NOZZLE

Install the bearing into the jet stator. The bearing should require a light press fit. Apply marine grease liberally to

Install the steering nozzle onto the stator with 2x M3x8 SHCS.

Position the impeller on the shaft by bottoming out the shaft against the stator, and moving 5mm back. Secure the impeller with a radially installed grub screw. Insert into stator bearing.

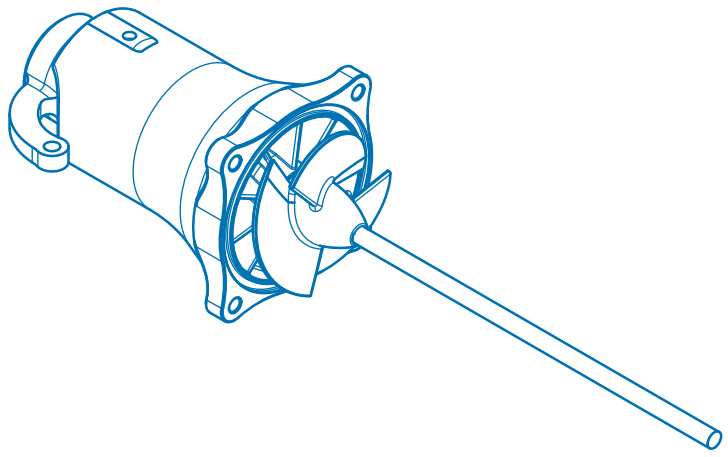
[picture p56: figure]

## OUTBOARD JET INSTALLATION

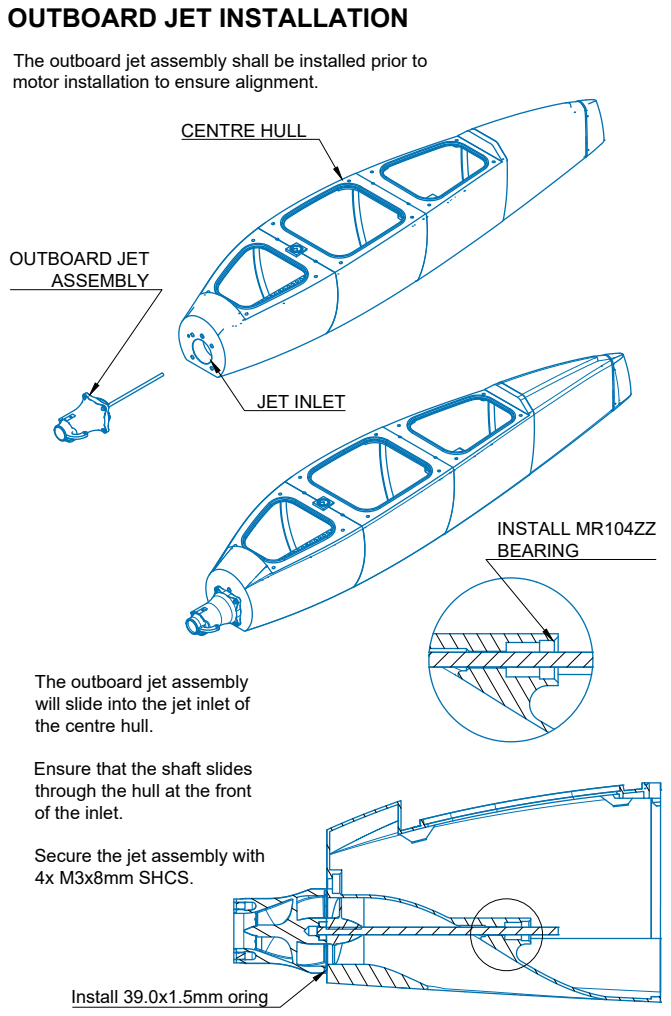
[picture p57: page 10]
CENTRE HULL; OUTBOARD JET ASSEMBLY; JET INLET; INSTALL MR104ZZ BEARING; Install 39.0x1.5mm oring

The outboard jet assembly shall be installed prior to
motor installation to ensure alignment.

The outboard jet assembly
will slide into the jet inlet of
the centre hull.

Ensure that the shaft slides
through the hull at the front
of the inlet.

Secure the jet assembly with
4x M3x8mm SHCS.

## MOTOR ASSEMBLY

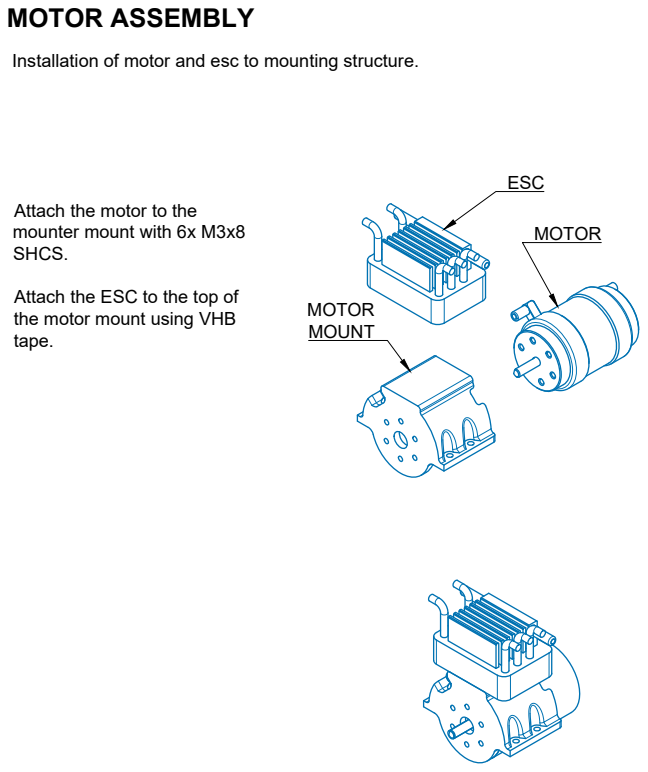
[picture p58: page 11]
ESC; MOTOR; MOTOR MOUNT

Installation of motor and esc to mounting structure.

Attach the motor to the
mounter mount with 6x M3x8
SHCS.

Attach the ESC to the top of
the motor mount using VHB
tape.

## MOTOR & SERVO INSTALLATION

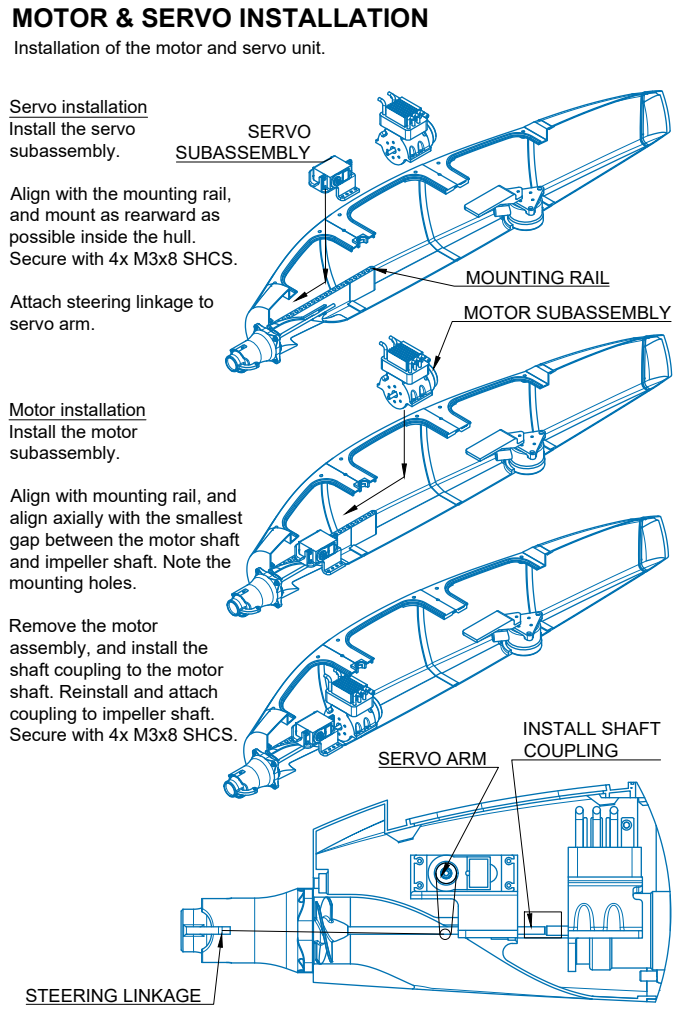
[picture p59: page 12]
Secure with 4x M3x8 SHCS.; INSTALL SHAFT; STEERING LINKAGE; SERVO SUBASSEMBLY; MOTOR SUBASSEMBLY; MOUNTING RAIL

Installation of the motor and servo unit.

Servo installation
Install the servo
subassembly.

Align with the mounting rail,
and mount as rearward as
possible inside the hull.
Secure with 4x M3x8 SHCS.

Attach steering linkage to
servo arm.

Motor installation
Install the motor

Align with mounting rail, and
align axially with the smallest
gap between the motor shaft
and impeller shaft. Note the
mounting holes.

Remove the motor
assembly, and install the
shaft coupling to the motor
shaft. Reinstall and attach
coupling to impeller shaft.

COUPLING SERVO ARM

## BATTERY INSTALLATION

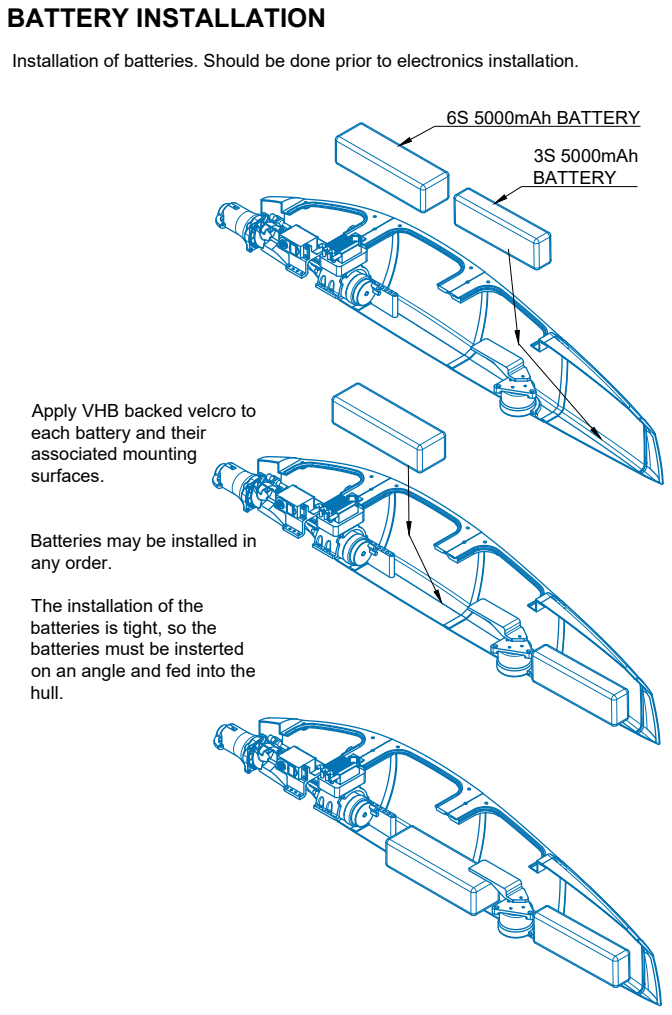
[picture p60: page 13]
6S 5000mAh BATTERY; 3S 5000mAh BATTERY

Installation of batteries. Should be done prior to electronics installation.

Apply VHB backed velcro to
each battery and their
associated mounting
surfaces.

Batteries may be installed in
any order.

The installation of the
batteries is tight, so the
batteries must be insterted
on an angle and fed into the
hull.

## FLIGHT CONTROLLER BOX

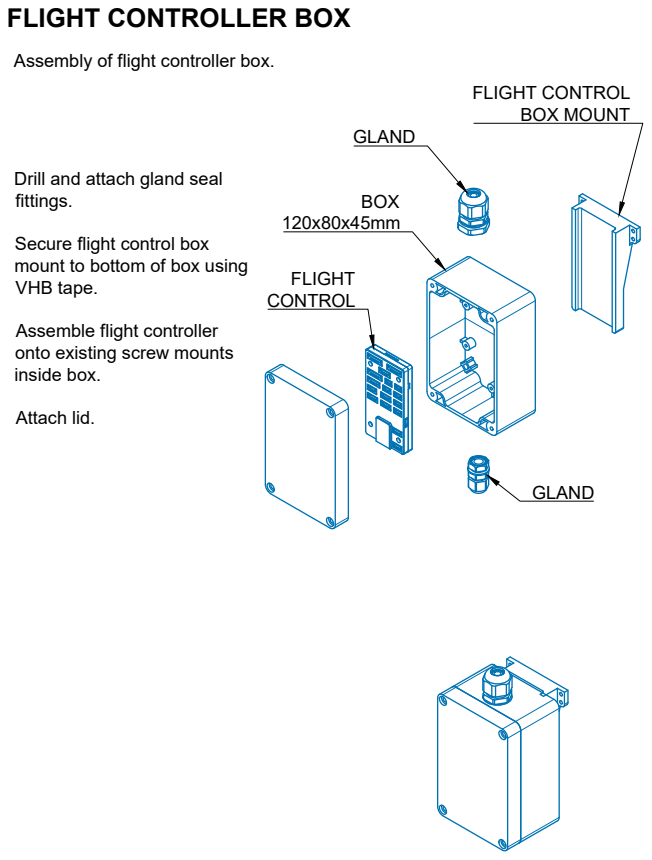
[picture p61: page 14]
Attach lid.; BOX 120x80x45mm; FLIGHT CONTROL BOX MOUNT; GLAND; FLIGHT CONTROL

Assembly of flight controller box.

Drill and attach gland seal
fittings.

Secure flight control box
mount to bottom of box using
VHB tape.

Assemble flight controller
onto existing screw mounts
inside box.

## RPi BOX

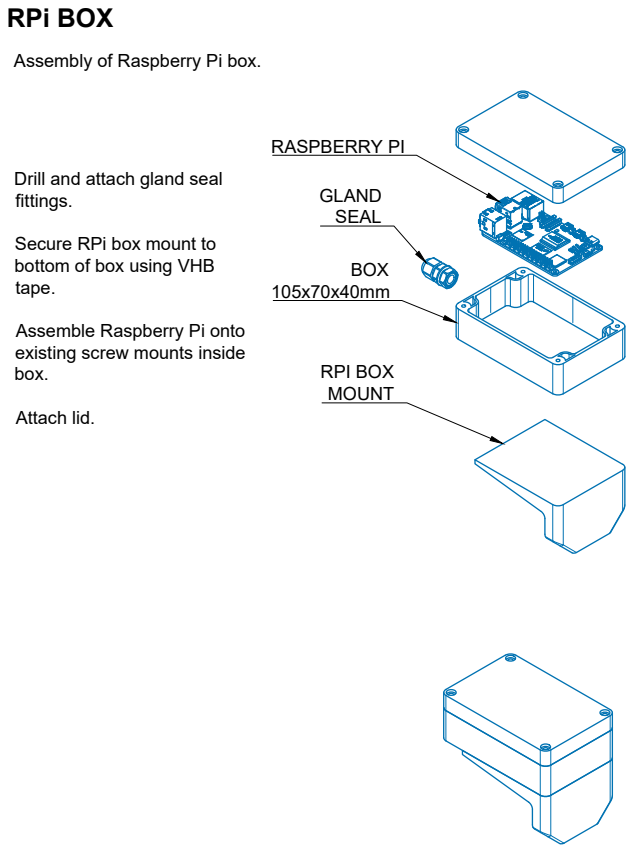
[picture p62: page 15]
Attach lid.; GLAND SEAL; RASPBERRY PI; BOX 105x70x40mm; RPI BOX MOUNT

Assembly of Raspberry Pi box.

Drill and attach gland seal
fittings.

Secure RPi box mount to
bottom of box using VHB
tape.

Assemble Raspberry Pi onto
existing screw mounts inside
box.

## ELECTRONICS INSTALLATION

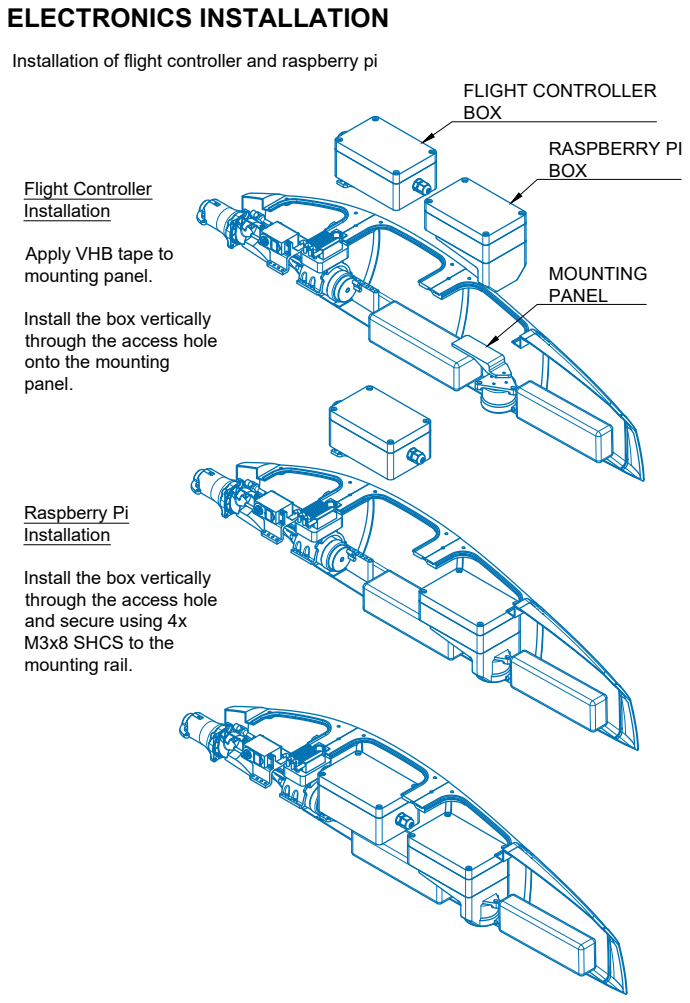
[picture p63: page 16]
Flight Controller Installation; Raspberry Pi Installation; RASPBERRY PI BOX; FLIGHT CONTROLLER BOX; MOUNTING PANEL

Installation of flight controller and raspberry pi

Apply VHB tape to
mounting panel.

Install the box vertically
through the access hole
onto the mounting
panel.

and secure using 4x
M3x8 SHCS to the
mounting rail.

## SIDE POD

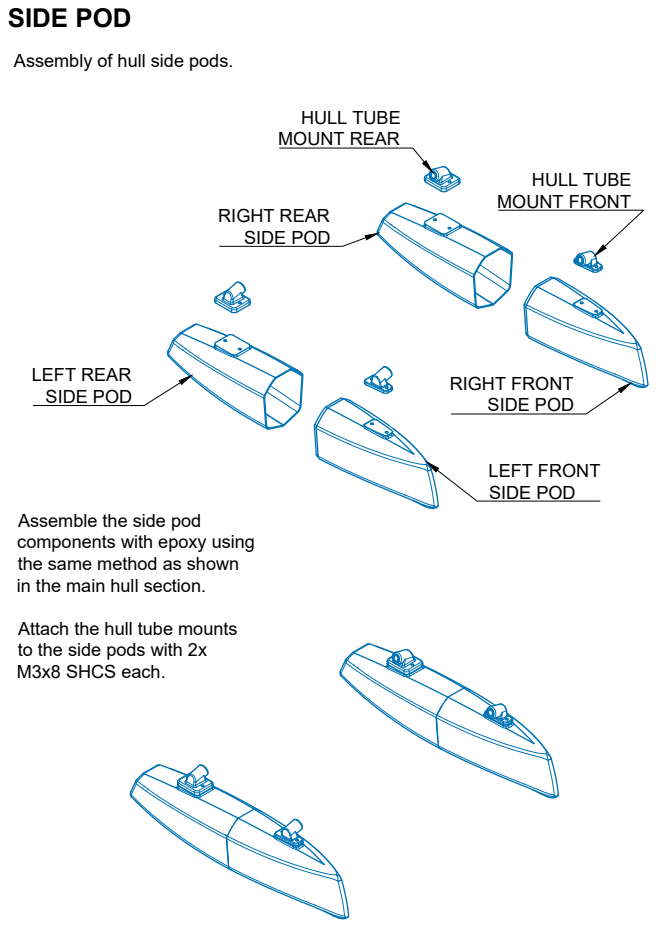
[picture p64: page 17]
LEFT REAR SIDE POD; LEFT FRONT SIDE POD; RIGHT FRONT SIDE POD; RIGHT REAR SIDE POD; HULL TUBE MOUNT REAR; HULL TUBE MOUNT FRONT

Assembly of hull side pods.

Assemble the side pod
components with epoxy using
the same method as shown
in the main hull section.

Attach the hull tube mounts
to the side pods with 2x
M3x8 SHCS each.

## SIDE POD STRUT ASSEMBLY

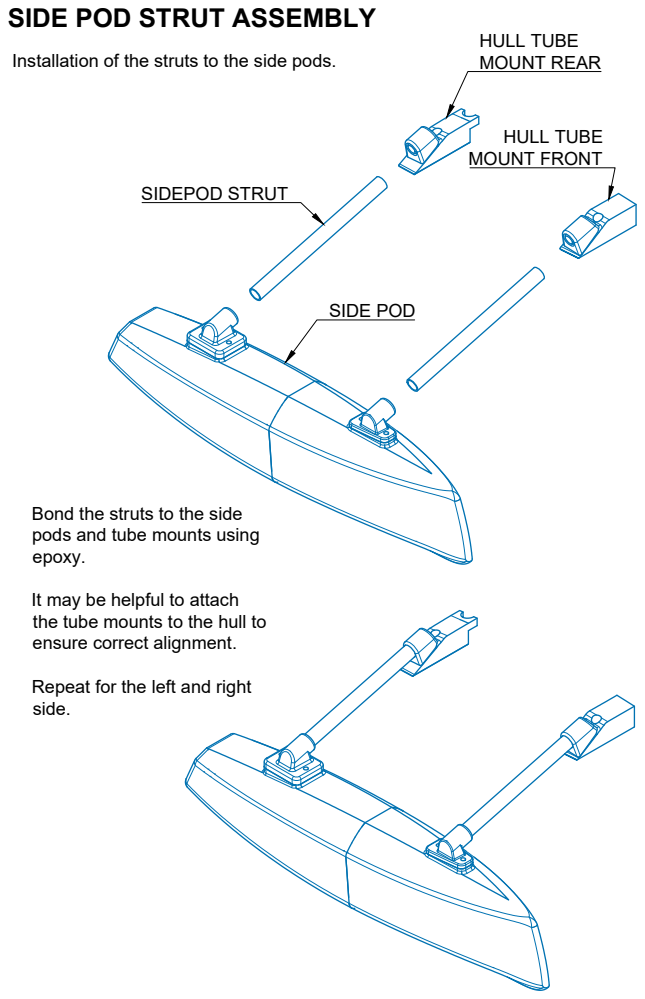
[picture p65: page 18]
SIDEPOD STRUT; SIDE POD; HULL TUBE MOUNT REAR; HULL TUBE MOUNT FRONT

Installation of the struts to the side pods.

Bond the struts to the side
pods and tube mounts using
epoxy.

It may be helpful to attach
the tube mounts to the hull to
ensure correct alignment.

Repeat for the left and right
side.

## GPS SENSOR POST

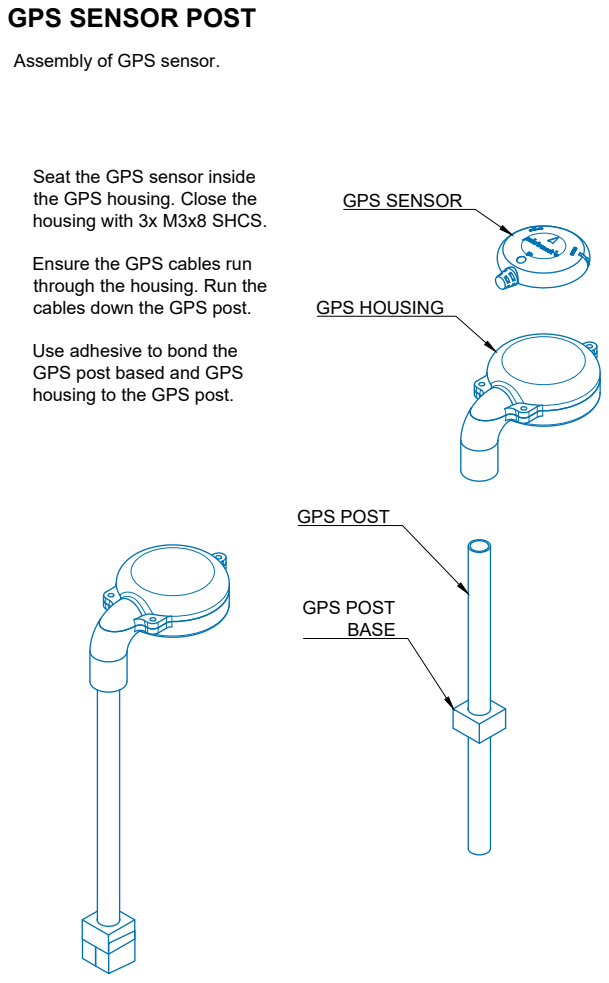
[picture p66: page 19]
GPS SENSOR; GPS HOUSING; GPS POST; GPS POST BASE

Assembly of GPS sensor.

Seat the GPS sensor inside
the GPS housing. Close the
housing with 3x M3x8 SHCS.

Ensure the GPS cables run
through the housing. Run the
cables down the GPS post.

Use adhesive to bond the
GPS post based and GPS
housing to the GPS post.

## SIDE POD INSTALLATION

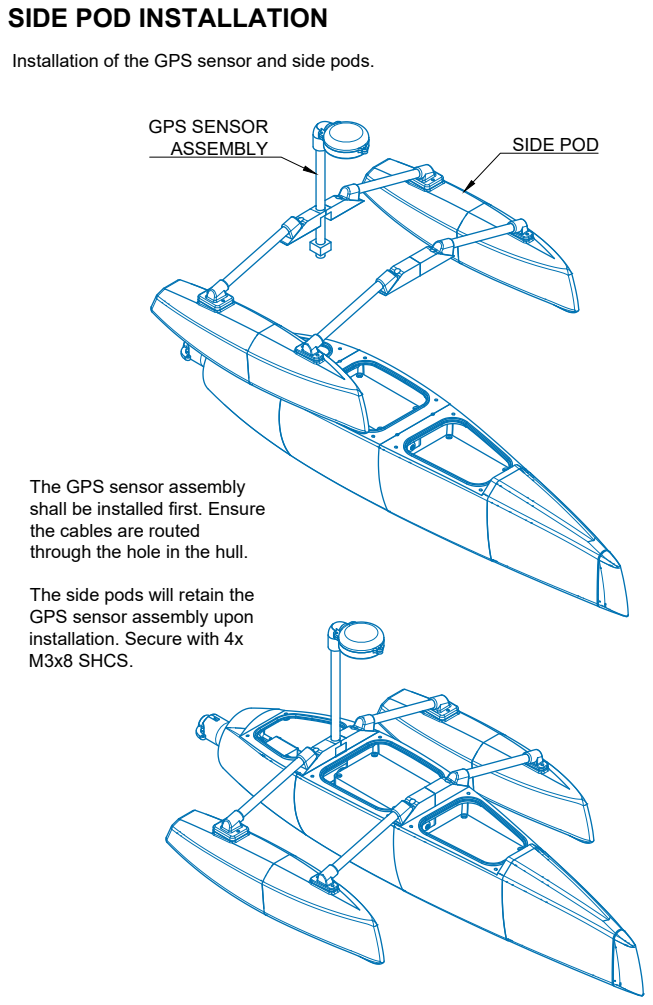
[picture p67: page 20]
GPS SENSOR; ASSEMBLY; SIDE POD

Installation of the GPS sensor and side pods.

The GPS sensor assembly
shall be installed first. Ensure
the cables are routed
through the hole in the hull.

The side pods will retain the
GPS sensor assembly upon
installation. Secure with 4x
M3x8 SHCS.

## LID ASSEMBLY

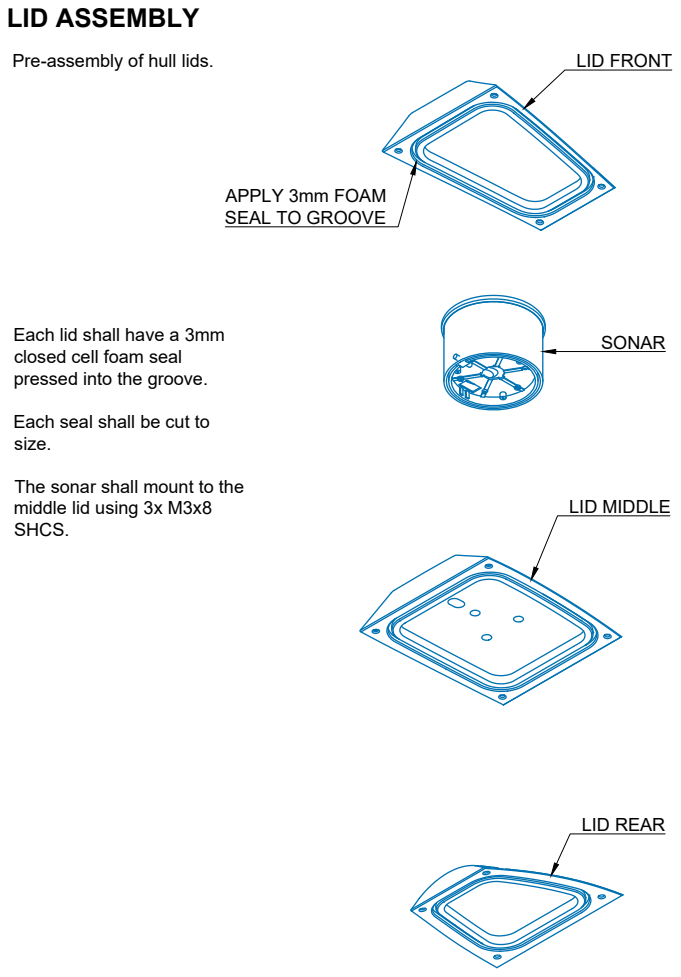
[picture p68: page 21]
LID FRONT; LID REAR; LID MIDDLE; SONAR

Pre-assembly of hull lids.

APPLY 3mm FOAM
SEAL TO GROOVE

Each lid shall have a 3mm
closed cell foam seal
pressed into the groove.

Each seal shall be cut to
size.

The sonar shall mount to the
middle lid using 3x M3x8
SHCS.

## CENTRE HULL LID INSTALLATION

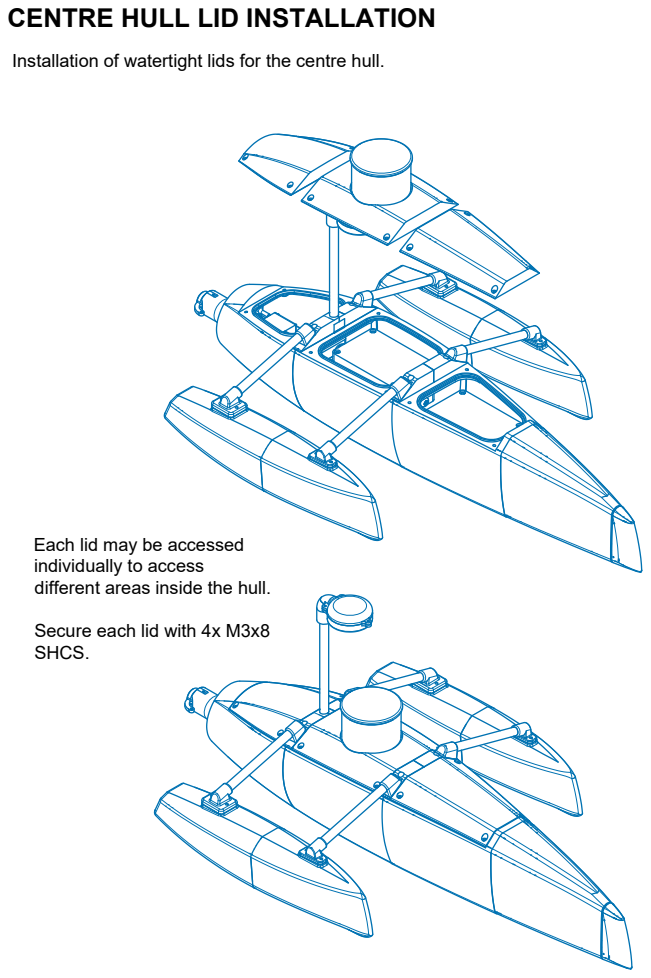
[picture p69: page 22]

Installation of watertight lids for the centre hull.

Each lid may be accessed
individually to access
different areas inside the hull.

Secure each lid with 4x M3x8
SHCS.
