newdexterity/Robotic-Speedboats/(commit log)

2021-09-22 Initial File Upload for 3D Printing Files
    3D printing files for the hull, cover, mounts and jet system.
    [Cover Front.3mf, Cover Rear.3mf, Hull Cutout Front Mid.3mf, Hull Cutout Front.3mf, Hull Cutout Mid Rear.3mf, Hull Cutout Rear.3mf, Hull_Cover.stp, Impeller_12_30_4.stl]
2024-03-28 Folder Restructure
    [Cover Front.3mf, Cover Rear.3mf, GPS_BASE.3mf, GPS_TOP.3mf, Hull Cutout Front Mid.3mf, Hull Cutout Front.3mf, Hull Cutout Mid Rear.3mf, Hull Cutout Rear.3mf]
2024-07-31 added Trimaran Assembly Instructions
2024-07-31 Version 2 3mf files added
    [GPS_BASE.3mf, GPS_TOP.3mf, Hull_Front.3mf, Hull_Middle.3mf, Hull_Nose.3mf, Hull_Rear.3mf, Hull_tube_mount_left_front.3mf, Hull_tube_mount_left_rear.3mf]
